arnemauer/IsaLib/ISA Ouderen/Ontvanger - Lamp/Glas met pictogrammen - achterkant.JPG

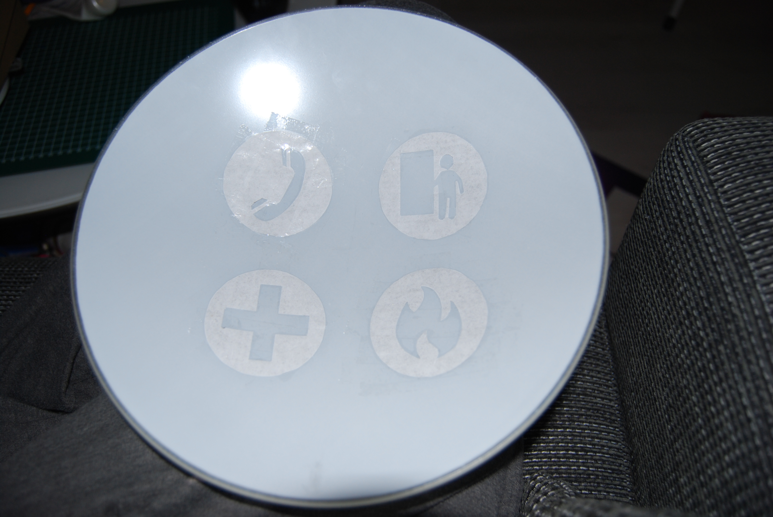
ISA Ouderen/Ontvanger - Lamp/Glas met pictogrammen - achterkant.JPG
