arnemauer/IsaLib/ISA Ouderen/Ontvanger - Lamp/Glas met pictogrammen - voorkant.JPG

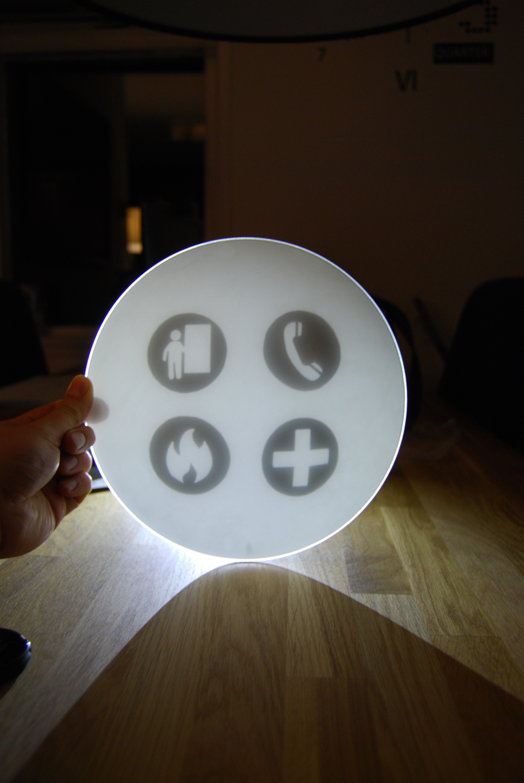
ISA Ouderen/Ontvanger - Lamp/Glas met pictogrammen - voorkant.JPG
