arnemauer/IsaLib/ISA Ouderen/Ontvanger - Lamp/Firmware (OUD)/LED PINS - KLEUREN.txt

Led: 0 - LINKSBOVEN - BLAUW
Led: 1 - LINKSBOVEN - GROEN
Led: 2 - LINKSBOVEN - ROOD

Led: 3 - WIT - ONDER
Led: 4 - WIT - LINKSBOVEN 
Led: 5 - WIT - MIDDENBOVEN 
Led: 6 - WIT - RECHTSBOVEN 

Led: 7 - RECHTSBOVEN - ROOD
Led: 8 - RECHTSBOVEN - GROEN
Led: 9 - RECHTSBOVEN - BLAUW

Led: 10 - RECHTSONDER - BLAUW
Led: 11 - RECHTSONDER - GROEN
Led: 12 - RECHTSONDER - ROOD

Led: 13 - LINKSONDER - BLAUW
Led: 14 - LINKSONDER - GROEN
Led: 15 - LINKSONDER - ROOD
