arnemauer/IsaLib/ISA Ouderen/Zender - Deurbel en Telefoon/Schematic/6n139 weerstand berekening.docx

Status | 6.8K | | 12.3K | | 39.4K
| 6.8K | 0K | 6.8K | 5.5K | 6.8K | 32.6K
Lijn in rust | 2.9mA | | 1.6mA | | 0.5mA
Rinkel 70v | 6.3mA | | 3.5mA | | 1.1mA
Rinkel 160v | 19.6mA | | 10.8mA | | 3.4mA
In gesprek | 0mA | | 0mA | | 0mA
