arnemauer/IsaLib/ISA Ouderen/Zender - Deurbel en Telefoon/Schematic/Deurbel meting/meting 1 benedenbel.XLS

Index | Value | Time | Unit
1 | 0,254 | 18:53:35:567 | DCV V
2 | 0,254 | 18:53:36:82 | DCV V
3 | 0,254 | 18:53:36:581 | DCV V
4 | 0,254 | 18:53:37:80 | DCV V
5 | 0,254 | 18:53:37:595 | DCV V
6 | 0,241 | 18:53:38:110 | DCV V
7 | 0,241 | 18:53:38:625 | DCV V
8 | 0,233 | 18:53:39:124 | DCV V
9 | -0,002 | 18:53:39:639 | DCV V
10 | -0,002 | 18:53:40:169 | DCV V
11 | 0,075 | 18:53:40:637 | DCV V
12 | 0,246 | 18:53:41:152 | DCV V
13 | 0,236 | 18:53:42:150 | DCV V
14 | 0,242 | 18:53:42:649 | DCV V
15 | 0,243 | 18:53:43:149 | DCV V
16 | 0,251 | 18:53:43:648 | DCV V
17 | 0,25 | 18:53:44:163 | DCV V
18 | 0,25 | 18:53:44:662 | DCV V
19 | 0,25 | 18:53:45:177 | DCV V
20 | 0,25 | 18:53:45:676 | DCV V
21 | 0,25 | 18:53:46:175 | DCV V
22 | 0,25 | 18:53:46:674 | DCV V
23 | 0,25 | 18:53:47:673 | DCV V
24 | 0,25 | 18:53:48:172 | DCV V
25 | 0,251 | 18:53:48:687 | DCV V
26 | 0,251 | 18:53:49:186 | DCV V
27 | 0,251 | 18:53:49:701 | DCV V
28 | 0,25 | 18:53:50:200 | DCV V
29 | 0,251 | 18:53:50:746 | DCV V
30 | 0,25 | 18:53:51:214 | DCV V
31 | 0,251 | 18:53:51:713 | DCV V
32 | 0,251 | 18:53:52:228 | DCV V
33 | 0,251 | 18:53:52:727 | DCV V
34 | 0,251 | 18:53:53:226 | DCV V
35 | 0,251 | 18:53:53:725 | DCV V
36 | 0,251 | 18:53:54:209 | DCV V
37 | 0,251 | 18:53:54:724 | DCV V
38 | 0,25 | 18:53:55:239 | DCV V
39 | 0,25 | 18:53:55:722 | DCV V
40 | 0,25 | 18:53:56:237 | DCV V
41 | 0,25 | 18:53:56:736 | DCV V
42 | 0,25 | 18:53:57:298 | DCV V
43 | 0,25 | 18:53:57:766 | DCV V
44 | 0,25 | 18:53:58:265 | DCV V
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
169 | 0,255 | 18:55:03:801 | DCV V
170 | 0,255 | 18:55:04:300 | DCV V
171 | 0,255 | 18:55:04:815 | DCV V
172 | 0,255 | 18:55:05:314 | DCV V
173 | 0,255 | 18:55:05:844 | DCV V
174 | 0,255 | 18:55:06:328 | DCV V
175 | 0,255 | 18:55:06:858 | DCV V
176 | 0,255 | 18:55:07:373 | DCV V
177 | 0,255 | 18:55:07:857 | DCV V
