arnemauer/IsaLib/ISA Gateway/Schematic - PCB/01-09-Board.png

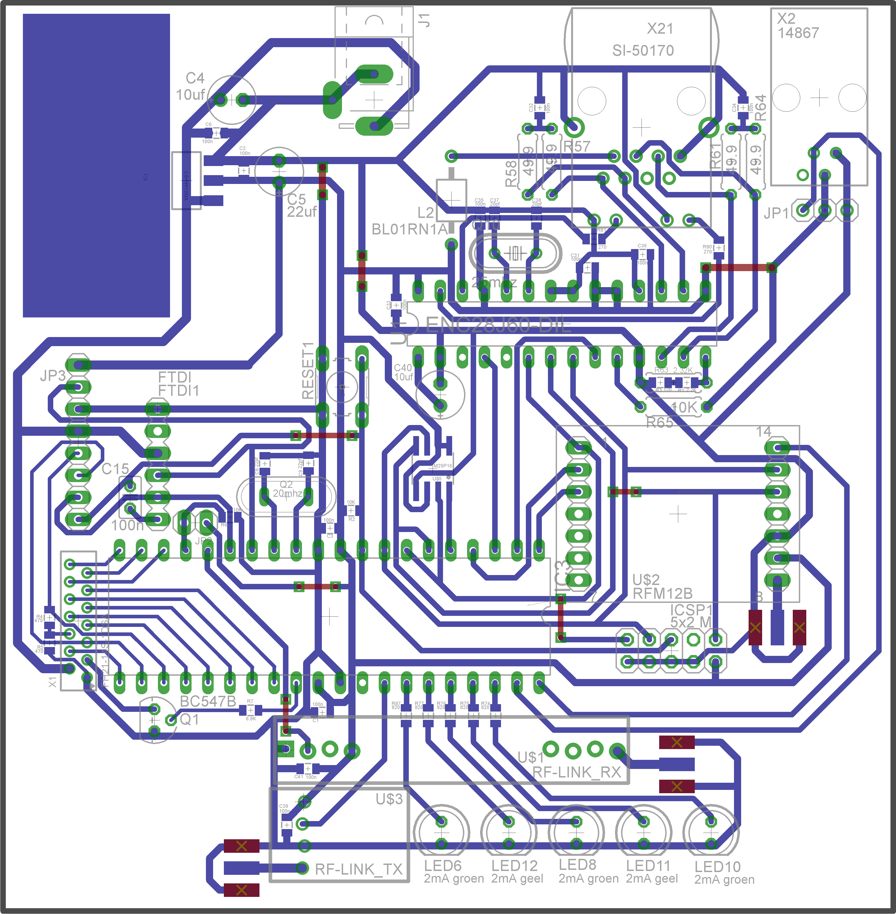
ISA Gateway/Schematic - PCB/01-09-Board.png
