arnemauer/IsaLib/ISA Gateway/Schematic - PCB/31-08-Board.png

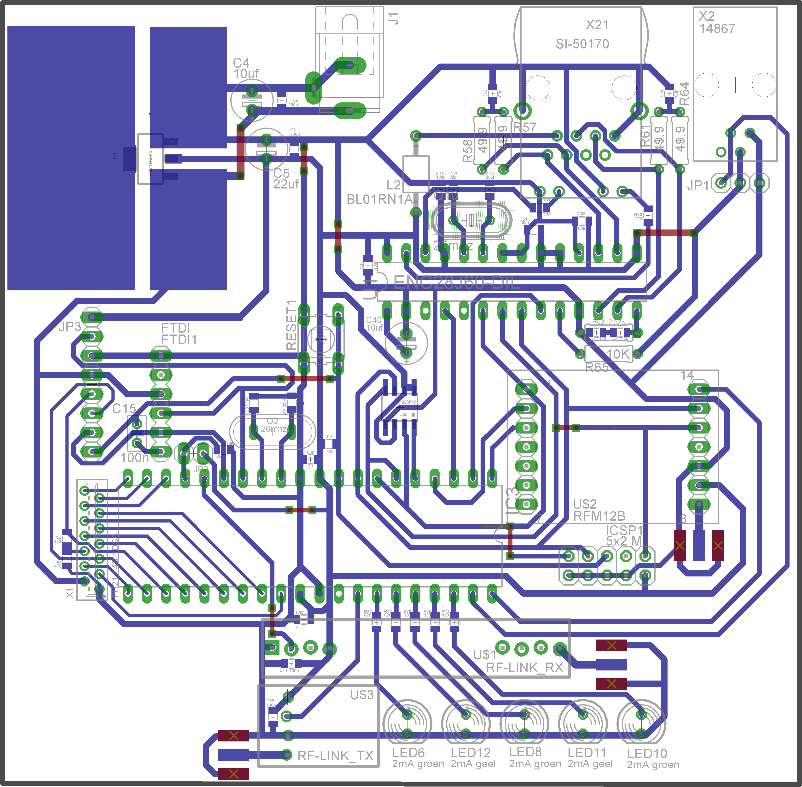
ISA Gateway/Schematic - PCB/31-08-Board.png
