arnemauer/IsaLib/ISA Ouderen/Ontvanger - Lamp/Glas met pictogrammen - voorkant 2.JPG

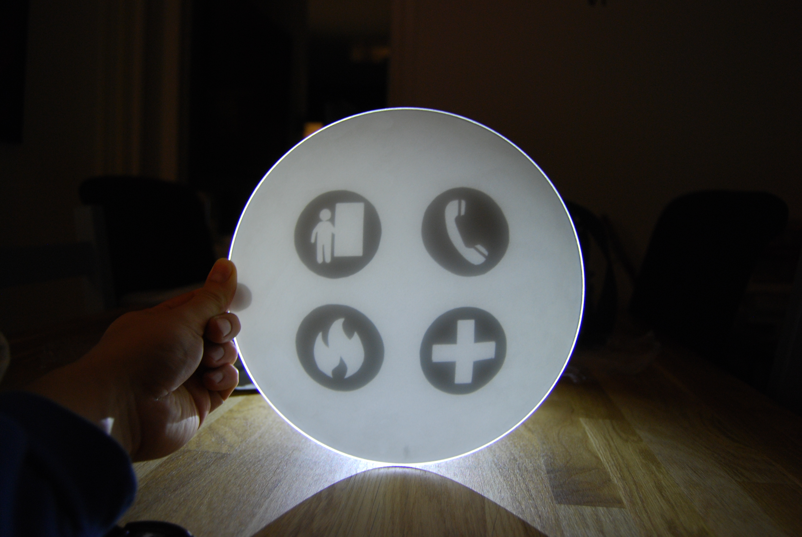
ISA Ouderen/Ontvanger - Lamp/Glas met pictogrammen - voorkant 2.JPG
