arnemauer/IsaLib/ISA Ouderen/Ontvanger - Lamp/Schematic/Schema.png

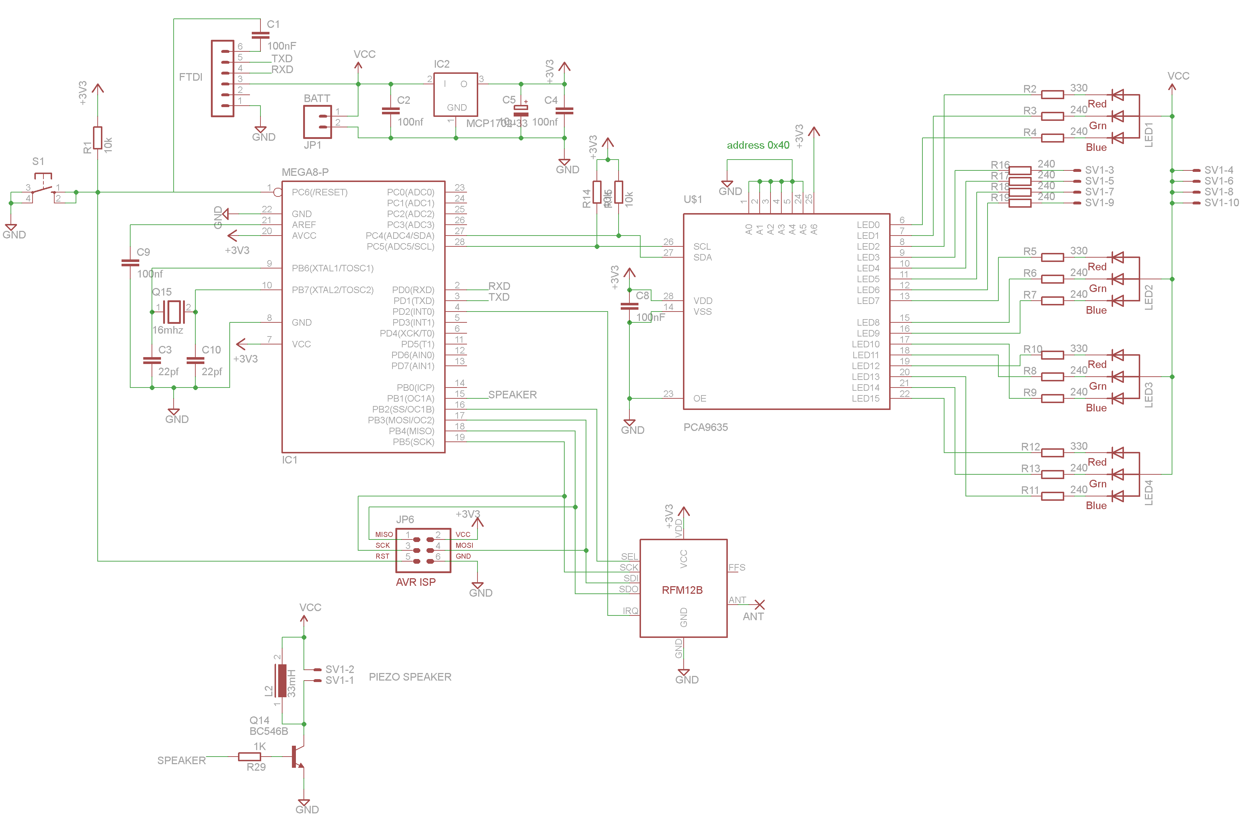
ISA Ouderen/Ontvanger - Lamp/Schematic/Schema.png
