arnemauer/IsaLib/ISA Ouderen/Zender - Deurbel en Telefoon/Schematic/Deurbel meting/meting 1 benedenbel.jpg

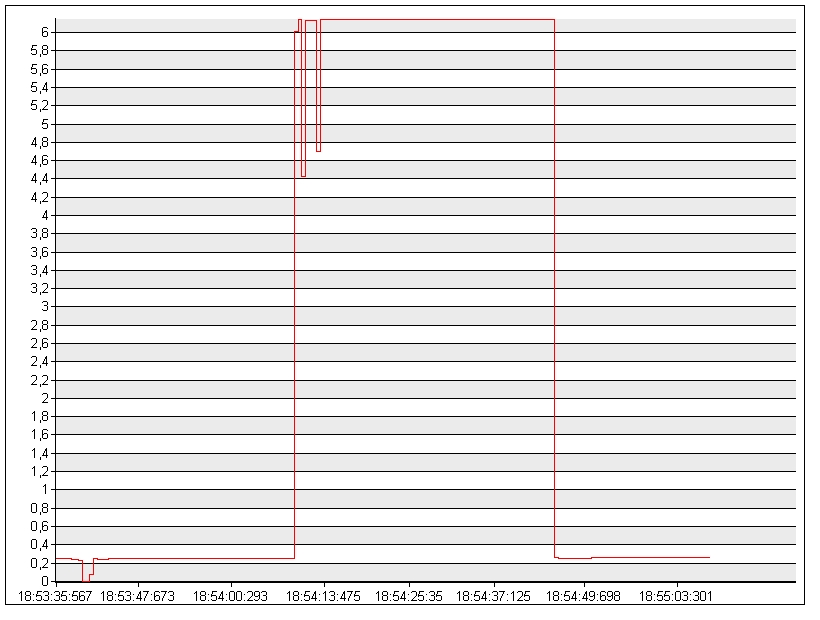
ISA Ouderen/Zender - Deurbel en Telefoon/Schematic/Deurbel meting/meting 1 benedenbel.jpg
