arnemauer/IsaLib/ISA Ouderen/Zender - Deurbel en Telefoon/Schematic/BOM/ISA Ouderen - Lamp Zender (versie 1).xlsx

Qty | Value | Device | Package | Shop | Price/s | Total |  | Parts | Description
2 | Antenna Wire | 1,6/0,8 | 1,6/0,8 |  |  |  | In huis | ANT, ANT2 | THROUGH-HOLE PAD
2 | 100k | R-EU_R0805 | R0805 | x | €0.06 | €0.12 | In huis | R2, R17 | RESISTOR, European symbol
6 | 100nf | C-EUC0805 | C0805 | x | €0.06 | €0.36 | In huis | C2, C3, C4, C8, C10, C11 | CAPACITOR, European symbol
4 | 10K | R-EU_R0805 | R0805 | x | €0.06 | €0.24 | In huis | R1, R8, R14, R16 | RESISTOR, European symbol
4 | 1N4007 | DIODE-DO214BA | DO214BA | Ebay | €0.02 | €0.08 | In huis | D7, D8, D9, D10 | DIODE
2 | 1N4148 | DIODESOD-323F | SOD-323F | Dickbest.nl | €0.06 | €0.12 | In huis | D1, D6 | Diode
2 | 1mm, 6x3,3x4,3mm | SWITCH-MOMENTARY-2-SMD-1101NE | TACTILE-SWITCH-1101NE | Dickbest.nl | €0.25 | €0.50 | In huis | S2, S3 | Various NO switches- pushbuttons, reed, etc
1 | 27V | ZENER-DIODEZD-2.5 | ZDIO-2.5 | Dickbest.nl | €0.10 | €0.10 | In huis | U$6 | Z-Diode
1 | 6.8K | R-EU_R0805 | R0805 | x | €0.06 | €0.06 | In huis | R6, R15 | RESISTOR, European symbol
1 | 680 | R-EU_R0805 | R0805 | x | €0.06 | €0.06 | In huis | R6, R15 | RESISTOR, European symbol
2 | 6N139 | HCPL0700 | SOIC08 | Ebay | €0.76 | €1.52 | In huis | OK2, OK4 | HEWLETT PACKARD OPTO COUPLER
2 | AVR-ISP-6VERT | AVR-ISP-6VERT | AVR-ISP-6 | x | €0.11 | €0.22 | In huis | JP3, JP6 | AVR ISP-6 Serial Programming Header
4 | BATTERY_1236_C | BATTERY_1236_C | BATTERY_1236_C | DX.com | €0.12 | €0.48 | Besteld | BATTERY_1, BATTERY_2, BATTERY_3, BATTERY_4 | SOC004
2 | BSH205 | MOSFET-PCHANNEL | SOT23 | Ebay | €1.44 | €2.88 | In huis | Q1, Q2
2 | FTDI | MA06-1 | MA06-1 | x | €0.07 | €0.14 | In huis | FTDI, FTDI2 | PIN HEADER
1 | MEGA8-AI | AVR-MEGA8-AI | TQFP32-08 | Ebay | €1.96 | €1.96 | In huis | IC4 | MICROCONTROLLER
1 | MEGA8-AI | MEGA8-AI | TQFP32-08@1 | Ebay | €1.96 | €1.96 | In huis | IC1 | MICROCONTROLLER
2 | RFM12B | RFM12B | RFM12B | ideetron.nl | €6.40 | €12.80 | Besteld | U$3, U$5
1 | 50K | TRIMPOT | TRIMPOT-5MM-V2 | Dickbest.nl | €0.85 | €0.85 | In huis | R3, R18 | Various small potentiometers for set-and-forget" applications"
1 | 10K | TRIMPOT | TRIMPOT-5MM-V2 | Dickbest.nl | €0.85 | €0.85 | In huis | R3, R18 | Various small potentiometers for set-and-forget" applications"
1 | s10k250 | VARISTOR-7,5 | R-7,5 | Dickbest.nl | €0.25 | €0.25 | In huis | R20 | VARISTOR
1 | PCB |  |  | Itead | €14.31 | €14.31 | Besteld
 |  |  |  |  | Totaal | €39.86
