arnemauer/IsaLib/ISA Ouderen/Zender - vor test ontvanger/Firmware - Deurbel/Fuses avrdude.rtf

Read Fuses:
avrdude -p atmega328 -c avrisp -P /dev/cu.usbserial-A600dWcL -b 9600 -U lfuse:r:-:h -U hfuse:r:-:h -U efuse:r:-:h -U lock:r:-:h

Compile optiboot
Add in make file:

atmega328_pro8: TARGET = atmega328_pro_8MHz
atmega328_pro8: CHIP = atmega328
atmega328_pro8:
$(MAKE) $(CHIP) AVR_FREQ=8000000L LED_START_FLASHES=3 DBAUD_RATE=9600
mv $(PROGRAM)_$(CHIP).hex $(PROGRAM)_$(TARGET).hex
mv $(PROGRAM)_$(CHIP).lst $(PROGRAM)_$(TARGET).lst

atmega328_pro8_isp: atmega328_pro8
atmega328_pro8_isp: TARGET = atmega328_pro_8MHz
atmega328_pro8_isp: MCU_TARGET = atmega328p
# 512 byte boot, SPIEN

atmega328_pro8_isp: HFUSE ?= DC
# Low power xtal (16MHz) 16KCK/14CK+65ms

atmega328_pro8_isp: LFUSE ?= E2
# 2.7V brownout

atmega328_pro8_isp: EFUSE ?= 06
atmega328_pro8_isp: isp

COMPILE COMMAND:
make atmega328_pro8 BAUD_RATE=9600

Write optiboot
LOW C2
HIGH DC
EXTENDED FE of 06

avrdude -p m328p -b 9600 -c avrisp -P /dev/tty.usbserial-A600dWcL -U flash:w:optiboot_atmega328_384_8.hex -U efuse:w:0x06:m -U hfuse:w:0xDC:m -U lfuse:w:0xE2:m -U lock:w:0x0F:m

avrdude -p m328p -b 9600 -c avrisp -P /dev/tty.usbserial-A600dWcL -U flash:w:ISA_OUDEREN_ZENDER.hex -U efuse:w:0x06:m -U hfuse:w:0xDC:m -U lfuse:w:0xE2:m -U lock:w:0x0F:m

avrdude -p m328p -b 115200 -c arduino -P /dev/tty.usbserial-A8009NB0 -U flash:w:ISA_OUDEREN_ZENDER.hex

avrdude -p m328p -b 9600 -c avrisp -P /dev/tty.usbserial-A600dWcL -U flash:w:ISA_OUDEREN_ZENDER.hex -U efuse:w:0x05:m -U hfuse:w:0xDA:m -U lfuse:w:0xE2:m -U lock:w:0x0F:m

avrdude -p m328p -b 9600 -c avrisp -P /dev/tty.usbserial-A600dWcL -U efuse:w:0x06:m -U hfuse:w:0xDC:m -U lfuse:w:0xC2:m -U lock:w:0x0F:m

ISA_OUDEREN_ZENDER

-CC:\WinAVR-20100110\bin\avrdude.conf -v -v -pm328p -carduino -P\\.\COM7 -b57600 -D -Uflash:w:"$(ProjectDir)Debug\$(ItemFileName).hex":i
