arnemauer/IsaLib/ISA Ouderen/Ontvanger - Lamp/Schematic/ISA Ouderen - Lamp Ontvanger.pdf

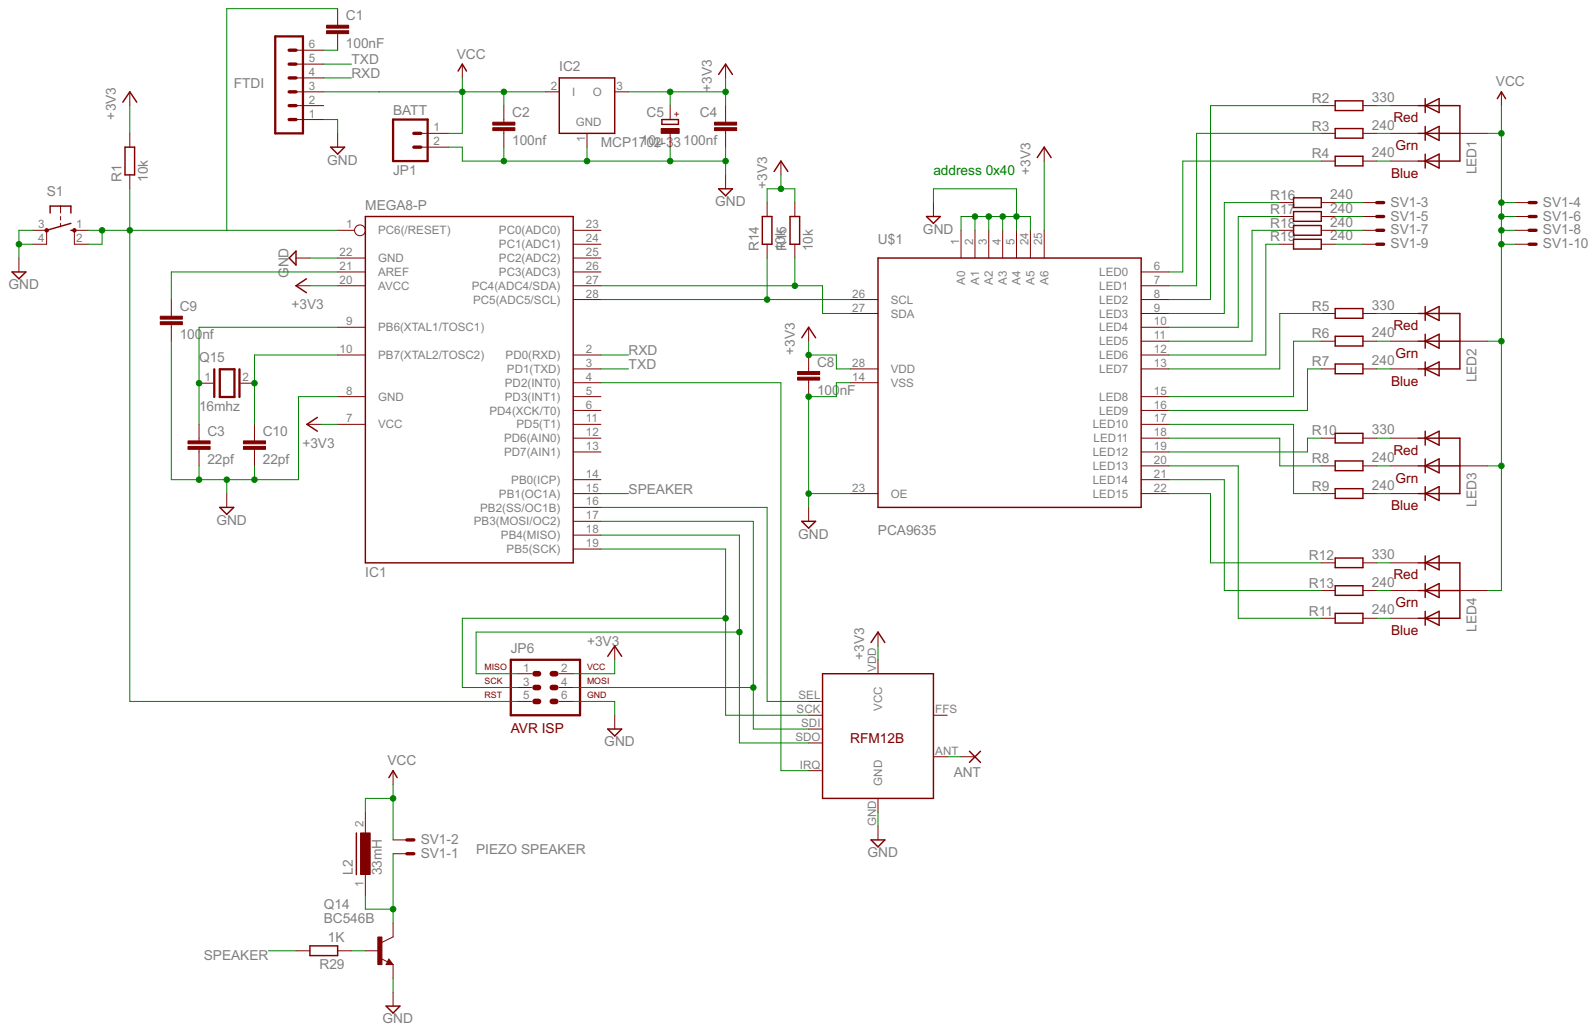
[picture p8: page 1]

10kGND MCP1702-33 100nF 100nf 10µ GND 100nf GND BATT GND BC546B GND 1K VCC 16mhz +3V3 GND +3V3 +3V3 VCC VCC PCA9635GND 100nF +3V3GND +3V3 +3V3100nf +3V3 GND MEGA8-P +3V3 22pf 22pf 330 240 240 330 240 240 240 240 330 240 330 240 33mH 10k 10k +3V3 GND 240 240 240 240 PIEZO SPEAKER 123456 FTDI R1 GND IC2I 2 O 3 1 C1 C2 C5 C4 JP1 12 ANT Q14 R29 Q15 1 2 LED0 6 LED1 7 LED2 8 LED3 9 LED4 10 LED5 11 LED6 12 LED7 13 LED8 15 LED9 16 LED10 17 LED11 18 LED12 19 LED13 20 LED14 21 LED15 22 SCL 26 SDA 27 VDD 28 VSS 14 OE 23 A0 1 A1 2 A2 3 A3 4 A4 5 A5 24 A6 25U$1 C8 JP63 2 51 64 SEL SCK SDI SDO ANT VCC VDD GND GND IRQ FFS C9 IC1 PB5(SCK) 19 PB7(XTAL2/TOSC2) 10 PB6(XTAL1/TOSC1) 9 GND 8 VCC 7 GND 22 AREF 21 AVCC 20 PB4(MISO) 18 PB3(MOSI/OC2) 17 PB2(SS/OC1B) 16 PB1(OC1A) 15 PB0(ICP) 14 PD7(AIN1) 13 PD6(AIN0) 12 PD5(T1) 11 PD4(XCK/T0) 6 PD3(INT1) 5 PD2(INT0) 4 PD1(TXD) 3 PD0(RXD) 2 PC5(ADC5/SCL) 28 PC4(ADC4/SDA) 27 PC3(ADC3) 26 PC2(ADC2) 25 PC1(ADC1) 24 PC0(ADC0) 23 PC6(/RESET) 1 C3 C10 R2R3R4R5R6R7R8R9R10 R11 R12 R13 L2 2 1 R14 R15 SV1-1 SV1-2 SV1-3 SV1-4 SV1-5 SV1-6 SV1-7 SV1-8 SV1-9 SV1-10 S1 3 1 4 2 LED1 LED2 LED3 LED4 R16 R17 R18 R19 RXD RXD TXD TXD SPEAKER SPEAKER+ AVR ISP SCK MOSI MISO VCC RST GND RFM12B Red Grn Blue Red Grn Blue Red Grn Blue Red Grn Blue address 0x40
