arnemauer/IsaLib/ISA Gateway/Schematic - PCB/01-09-Central relay.pdf

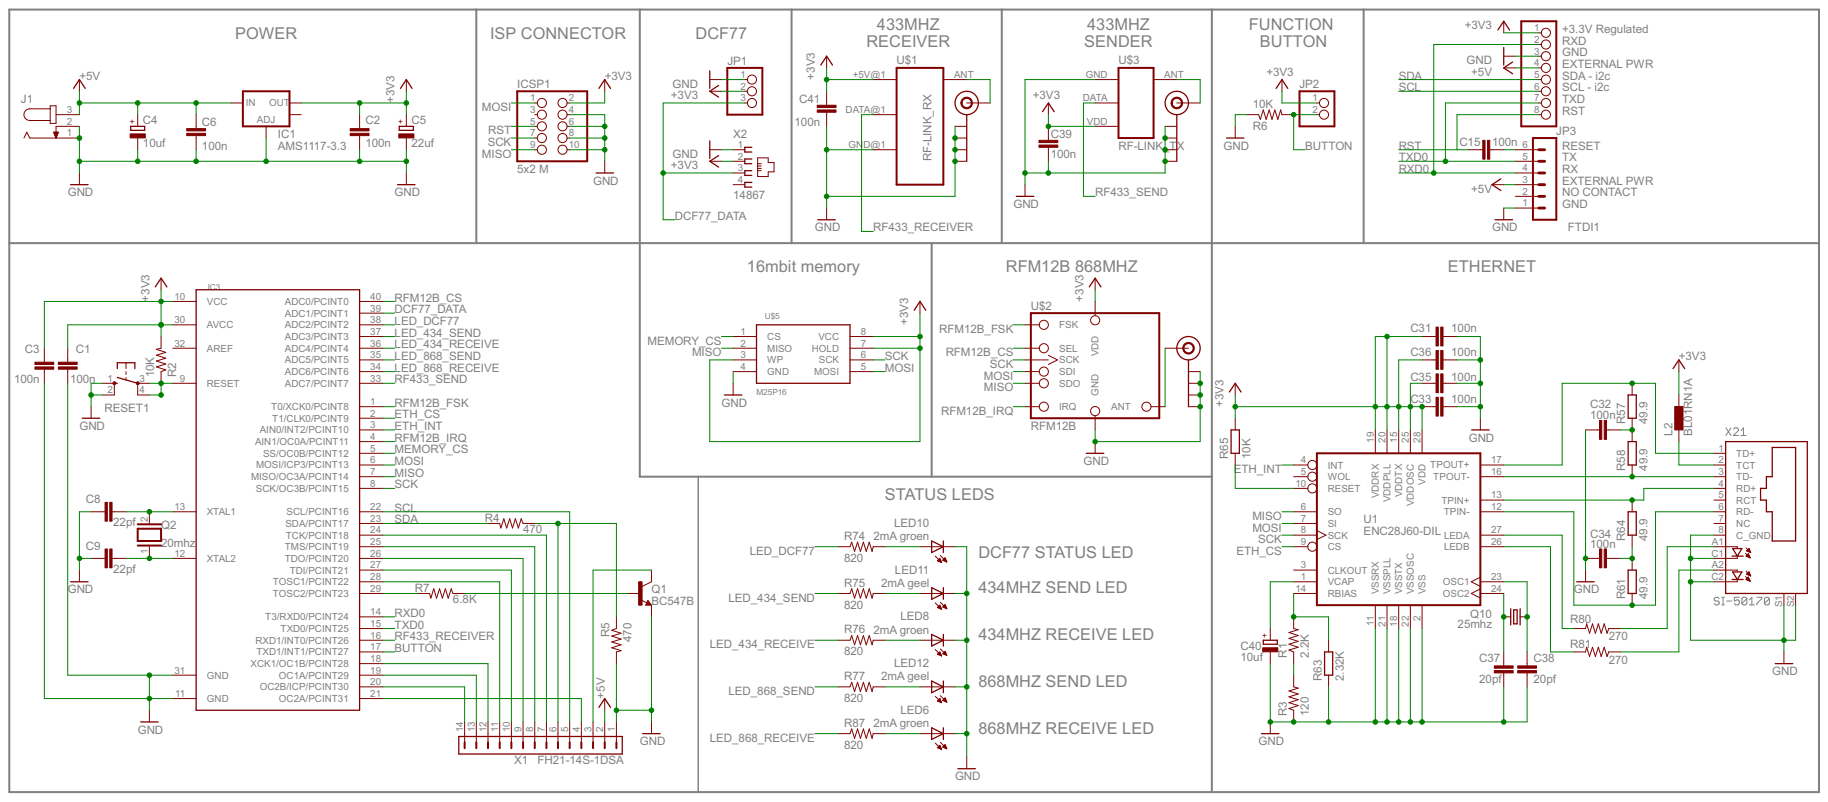
[picture p9: page 1]

7 8
9 10
