arnemauer/IsaLib/ISA Gateway/Schematic - PCB/31-08-Central relay.pdf

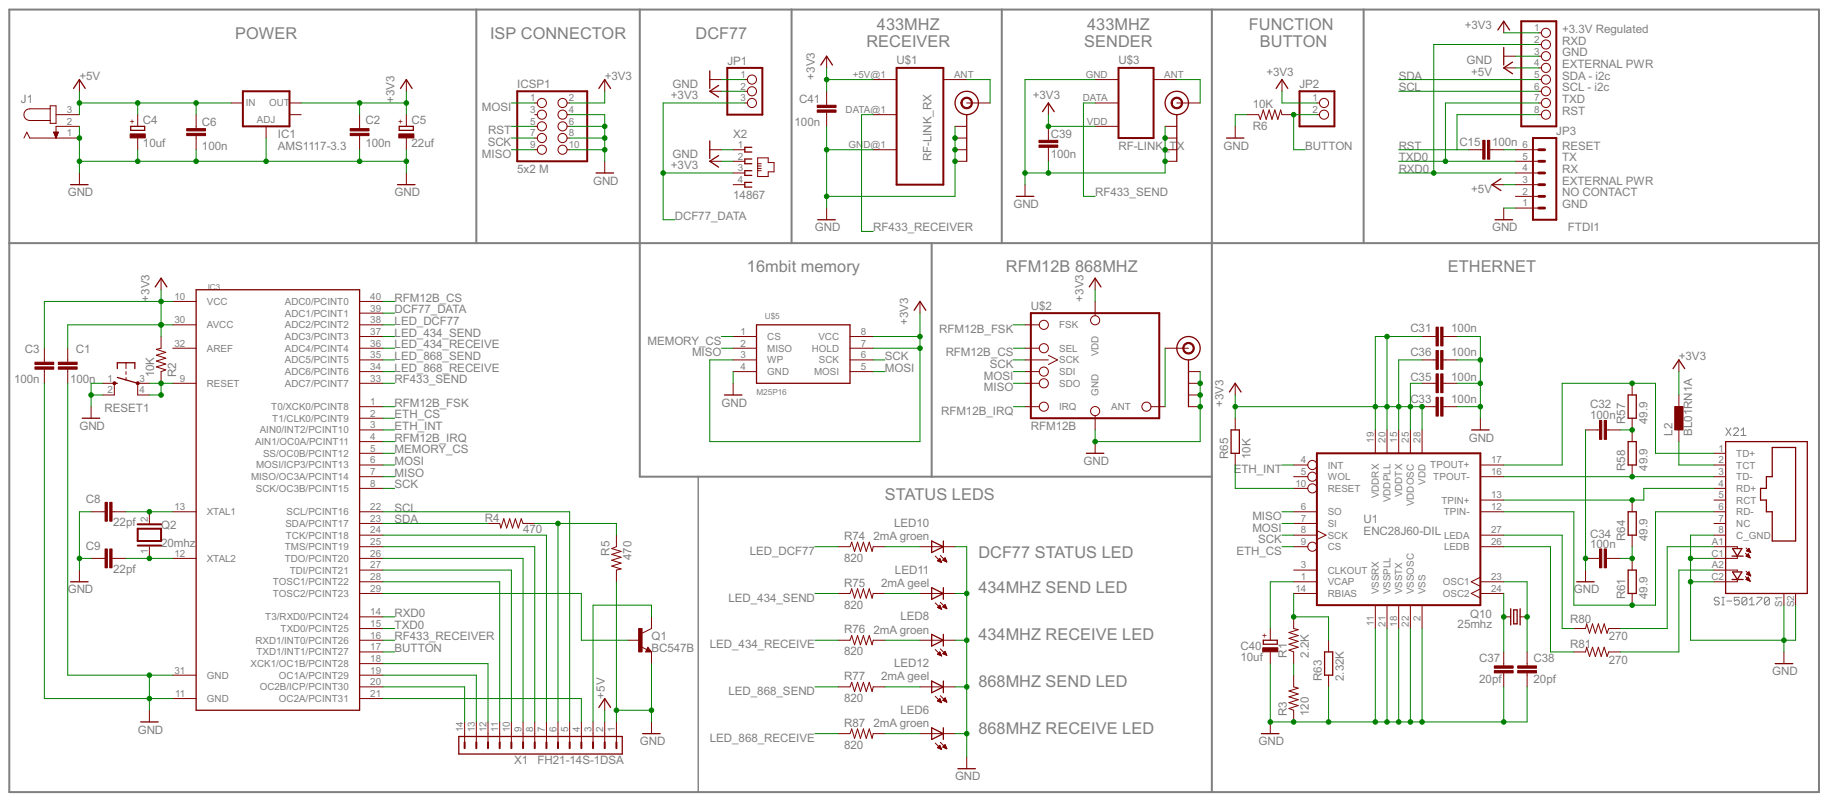
[picture p10: page 1]

7 8
9 10
