arnemauer/IsaLib/ISA Gateway/Schematic - PCB/Central relay.pdf

7 8
9 10
