arnemauer/IsaLib/ISA Gateway/Schematic - PCB/Central relay2.pdf

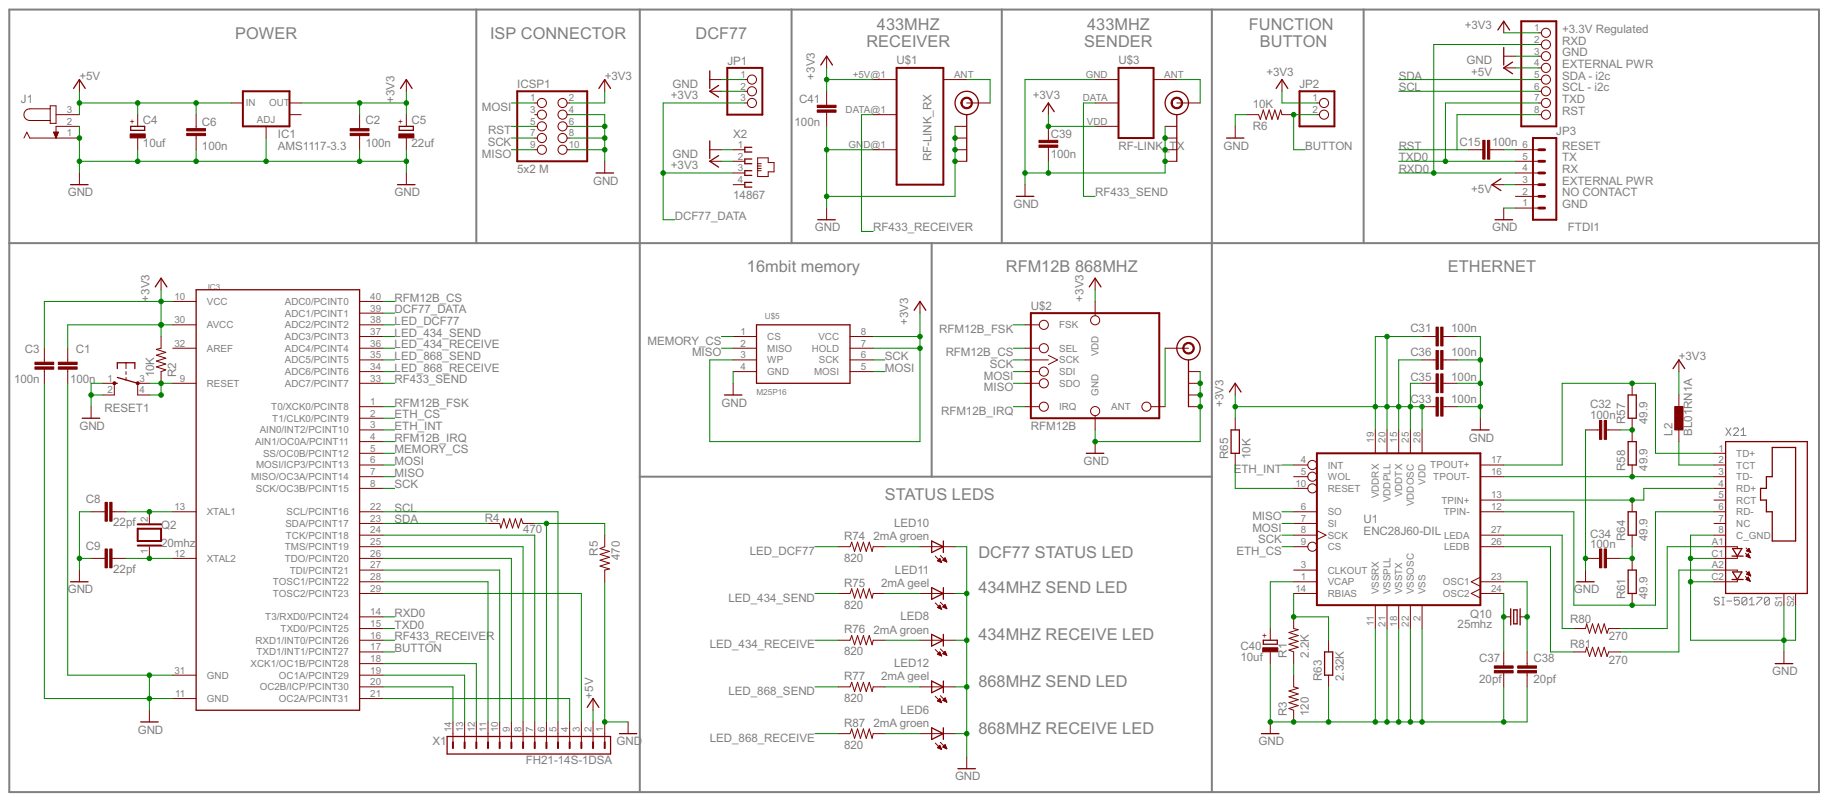
[picture p11: page 1]

7 8
9 10
