arnemauer/IsaLib/ISA Ouderen/Zender - Deurbel en Telefoon/Schematic/ISA Ouderen - Lamp Zender.pdf

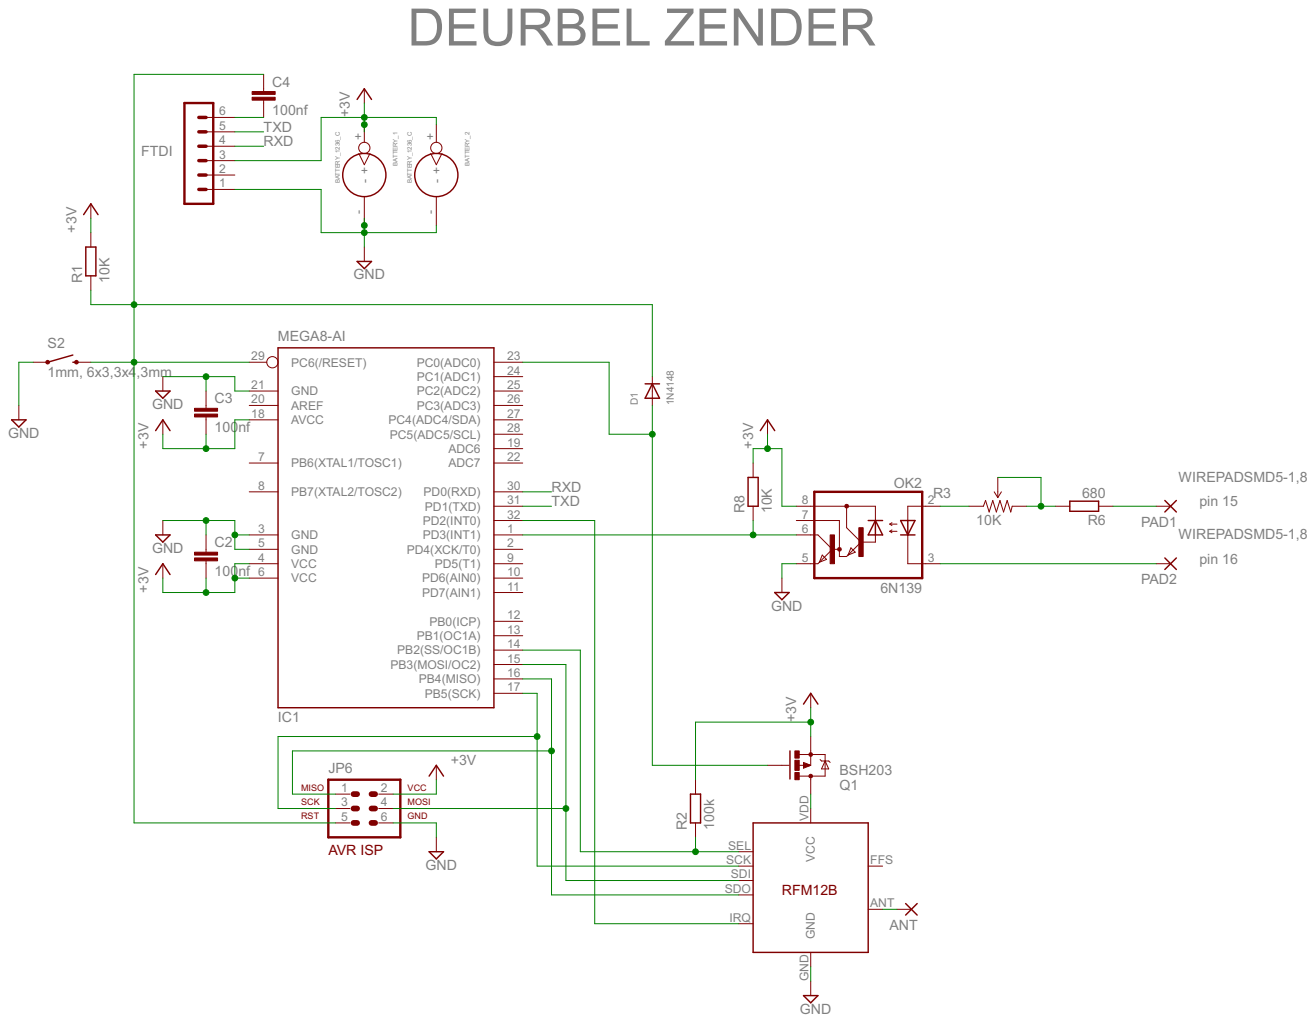
[picture p12: page 1]

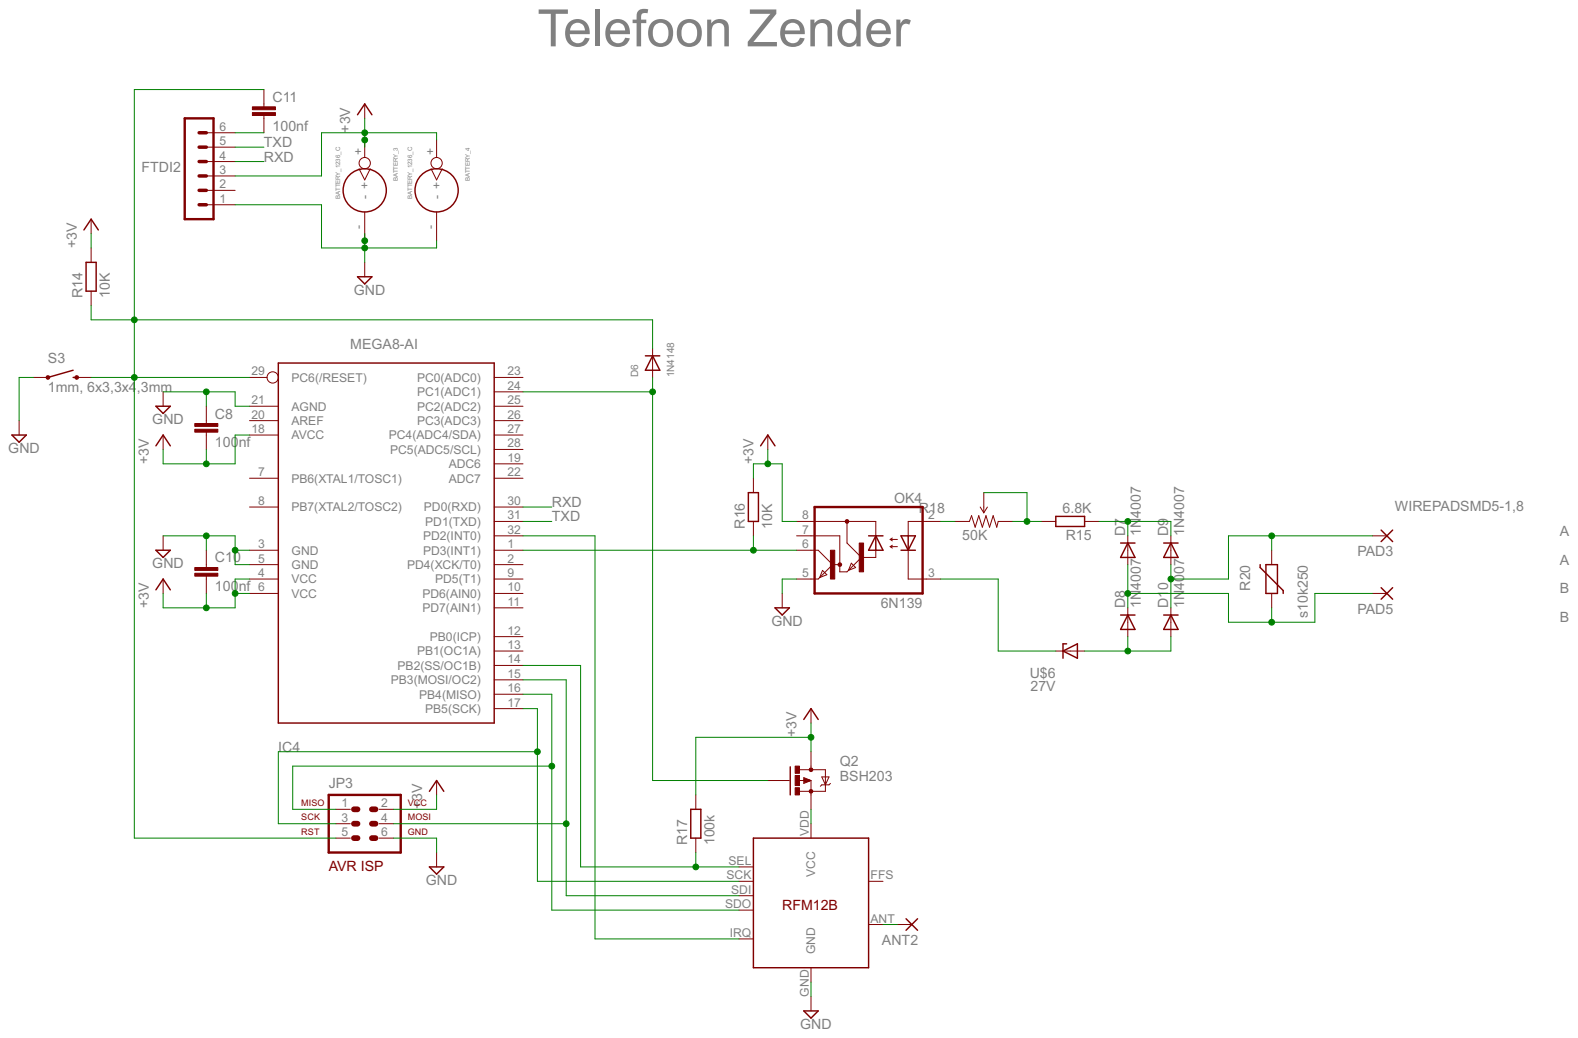
[picture p13: page 2]
