arnemauer/IsaLib/ISA Ouderen/Ontvanger - Lamp/Firmware (OUD)/ISA ouderen deurbel ontvanger - applicatie proces.pdf

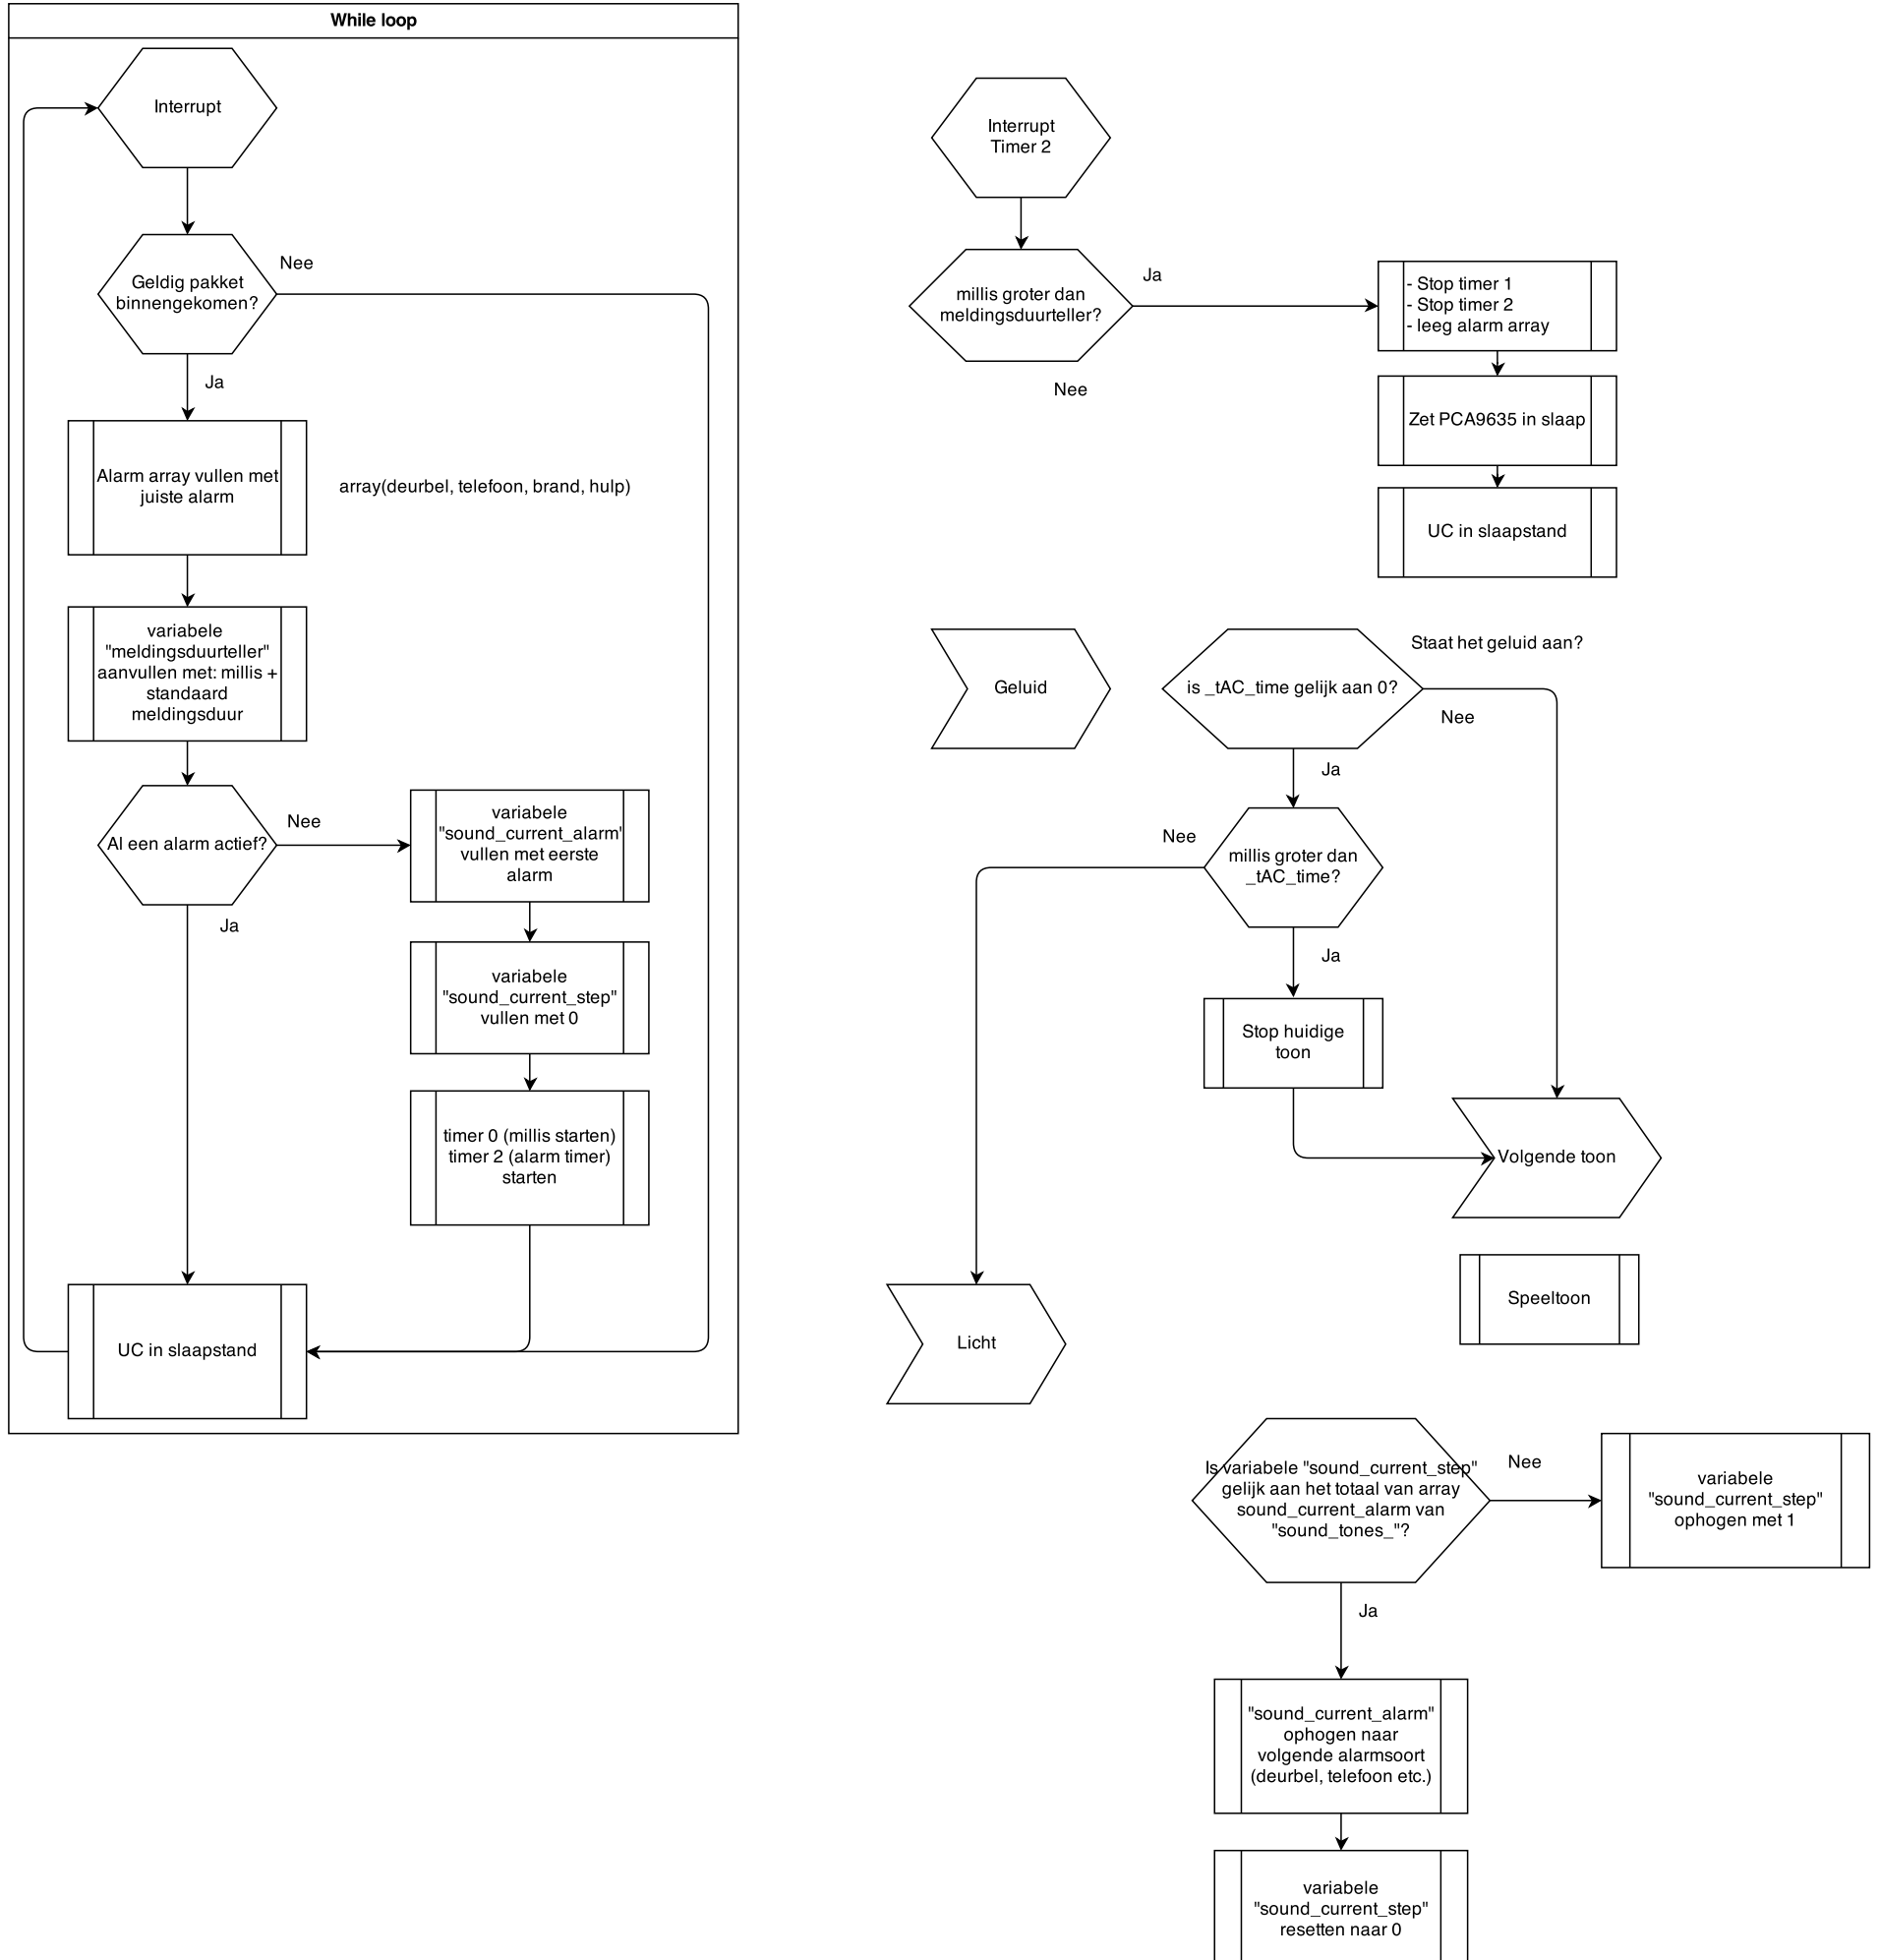
[picture p14: page 1]
