arnemauer/IsaLib/ISA Ouderen/Zender - Deurbel en Telefoon/Schematic/ISA Ouderen - Lamp Zender.brd

## EAGLE design ISA Ouderen/Zender - Deurbel en Telefoon/Schematic/ISA Ouderen - Lamp Zender.brd (2014-07-26)

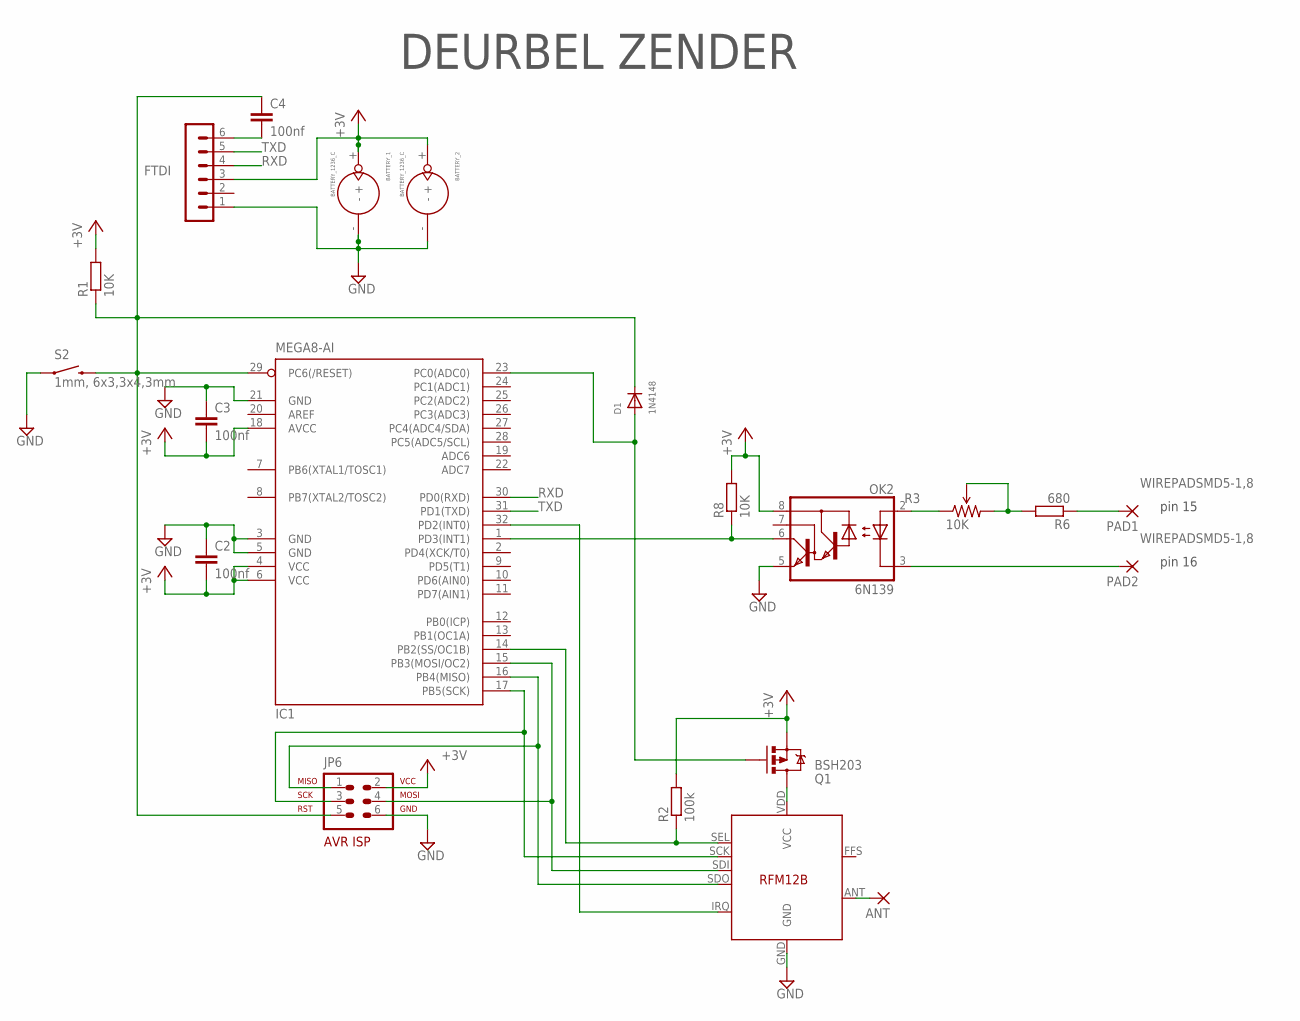
[picture p15: schematic ISA Ouderen - Lamp Zender.sch, sheet 1]

Parts:
ANT: 1,6/0,8
BATTERY_1, BATTERY_2: BATTERY_1236_C
C2, C3, C4: 100nf; C0805
D1: 1N4148; SOD-323F
FTDI: FTDI; MA06-1
IC1: MEGA8-AI; TQFP32-08@1
JP6: AVR-ISP-6VERT; AVR-ISP-6
OK2: 6N139; SOIC08
PAD1, PAD2: WIREPADSMD5-1,8; 5-1,8
Q1: BSH203; SOT23
R1, R8: 10K; R0805
R2: 100k; R0805
R3: 10K; TRIMPOT-5MM-V2
R6: 680; R0805
S2: 1mm, 6x3,3x4,3mm; TACTILE-SWITCH-1101NE
U$3: RFM12B

Connections:
+3V3: BATTERY_1.+, BATTERY_2.+, C2.2, C3.2, FTDI.3, IC1.4 (VCC), IC1.6 (VCC), IC1.18 (AVCC), JP6.2, OK2.8 (VCC), Q1.2 (S), R1.2, R2.2, R8.2; also elsewhere on the board
GND: BATTERY_1.-, BATTERY_2.-, C2.1, C3.1, FTDI.1, IC1.3 (GND), IC1.5 (GND), IC1.21 (GND), JP6.6, OK2.5 (GND), S2.P$1 (1), U$3.GND; also elsewhere on the board
unnamed: Q1.3 (D), U$3.VDD (VCC)
unnamed: D1.A, IC1.23 (PC0(ADC0)), Q1.1 (G)
unnamed: ANT.1, U$3.ANT
unnamed: IC1.14 (PB2(SS/OC1B)), R2.1, U$3.SEL
unnamed: IC1.32 (PD2(INT0)), U$3.IRQ
unnamed: PAD1.1, R6.1
unnamed: IC1.16 (PB4(MISO)), JP6.1, U$3.SDO
unnamed: OK2.2 (A), R3.A (CCW)
unnamed: IC1.17 (PB5(SCK)), JP6.3, U$3.SCK
unnamed: C4.2, FTDI.6
unnamed: OK2.3 (C), PAD2.1
unnamed: IC1.1 (PD3(INT1)), OK2.6 (VO), R8.1
unnamed: R3.B (WIPER), R3.C (CW), R6.2
unnamed: IC1.15 (PB3(MOSI/OC2)), JP6.4, U$3.SDI
RST: C4.1, D1.C, IC1.29 (PC6(/RESET)), JP6.5, R1.1, S2.P$2 (2)
RXD: FTDI.4, IC1.30 (PD0(RXD)); also elsewhere on the board
TXD: FTDI.5, IC1.31 (PD1(TXD)); also elsewhere on the board

Notes on the sheet:
pin 15
pin 16
DEURBEL ZENDER

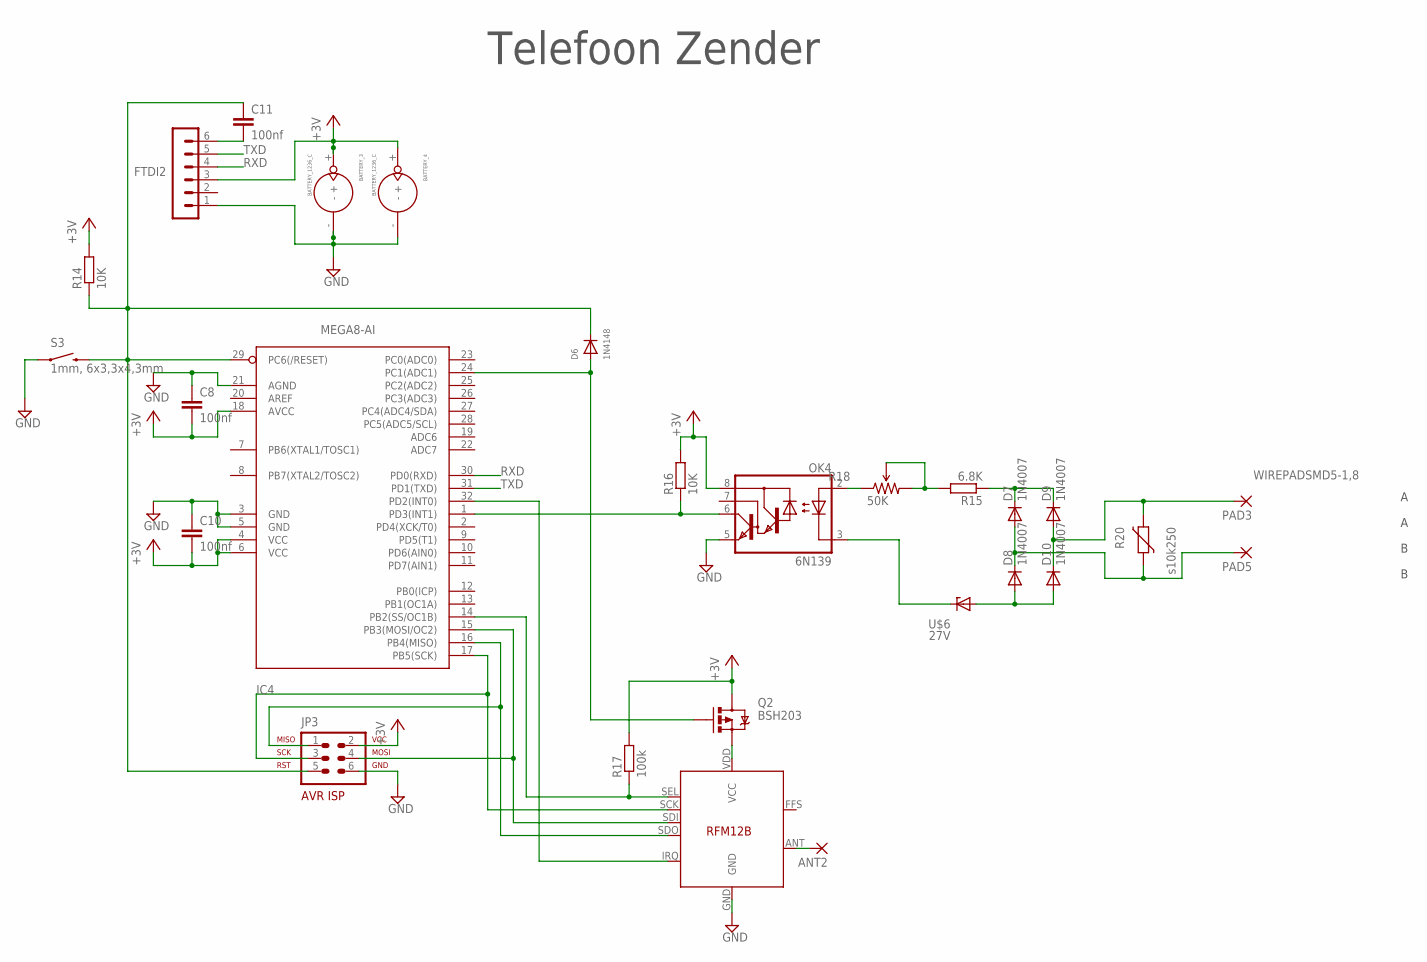
[picture p16: schematic ISA Ouderen - Lamp Zender.sch, sheet 2]

Parts:
ANT2: 1,6/0,8
BATTERY_3, BATTERY_4: BATTERY_1236_C
C8, C10, C11: 100nf; C0805
D6: 1N4148; SOD-323F
D7, D8, D9, D10: 1N4007; DO214BA
FTDI2: FTDI; MA06-1
IC4: MEGA8-AI; TQFP32-08
JP3: AVR-ISP-6VERT; AVR-ISP-6
OK4: 6N139; SOIC08
PAD3, PAD5: WIREPADSMD5-1,8; 5-1,8
Q2: BSH203; SOT23
R14, R16: 10K; R0805
R15: 6.8K; R0805
R17: 100k; R0805
R18: 50K; TRIMPOT-5MM-V2
R20: s10k250; R-7,5
S3: 1mm, 6x3,3x4,3mm; TACTILE-SWITCH-1101NE
U$5: RFM12B
U$6: 27V; ZDIO-2.5

Connections:
+3V3: BATTERY_3.+, BATTERY_4.+, C8.2, C10.2, FTDI2.3, IC4.4 (VCC), IC4.6 (VCC), IC4.18 (AVCC), JP3.2, OK4.8 (VCC), Q2.3 (D), R14.2, R16.2, R17.2; also elsewhere on the board
GND: BATTERY_3.-, BATTERY_4.-, C8.1, C10.1, FTDI2.1, IC4.3 (GND), IC4.5 (GND), IC4.21 (AGND), JP3.6, OK4.5 (GND), S3.P$1 (1), U$5.GND; also elsewhere on the board
unnamed: IC4.14 (PB2(SS/OC1B)), R17.1, U$5.SEL
unnamed: IC4.32 (PD2(INT0)), U$5.IRQ
unnamed: C11.2, FTDI2.6
unnamed: IC4.15 (PB3(MOSI/OC2)), JP3.4, U$5.SDI
unnamed: ANT2.1, U$5.ANT
unnamed: IC4.16 (PB4(MISO)), JP3.1, U$5.SDO
unnamed: IC4.17 (PB5(SCK)), JP3.3, U$5.SCK
unnamed: OK4.2 (A), R18.A (CCW)
unnamed: OK4.3 (C), U$6.C
unnamed: IC4.1 (PD3(INT1)), OK4.6 (VO), R16.1
unnamed: R15.2, R18.B (WIPER), R18.C (CW)
unnamed: Q2.2 (S), U$5.VDD (VCC)
unnamed: D6.A, IC4.24 (PC1(ADC1)), Q2.1 (G)
unnamed: D9.A, D10.C, PAD3.1, R20.2
unnamed: D7.A, D8.C, PAD5.1, R20.1
unnamed: D8.A, D10.A, U$6.A
unnamed: D7.C, D9.C, R15.1
RST2: C11.1, D6.C, IC4.29 (PC6(/RESET)), JP3.5, R14.1, S3.P$2 (2)
RXD: FTDI2.4, IC4.30 (PD0(RXD)); also elsewhere on the board
TXD: FTDI2.5, IC4.31 (PD1(TXD)); also elsewhere on the board

Notes on the sheet:
Telefoon Zender

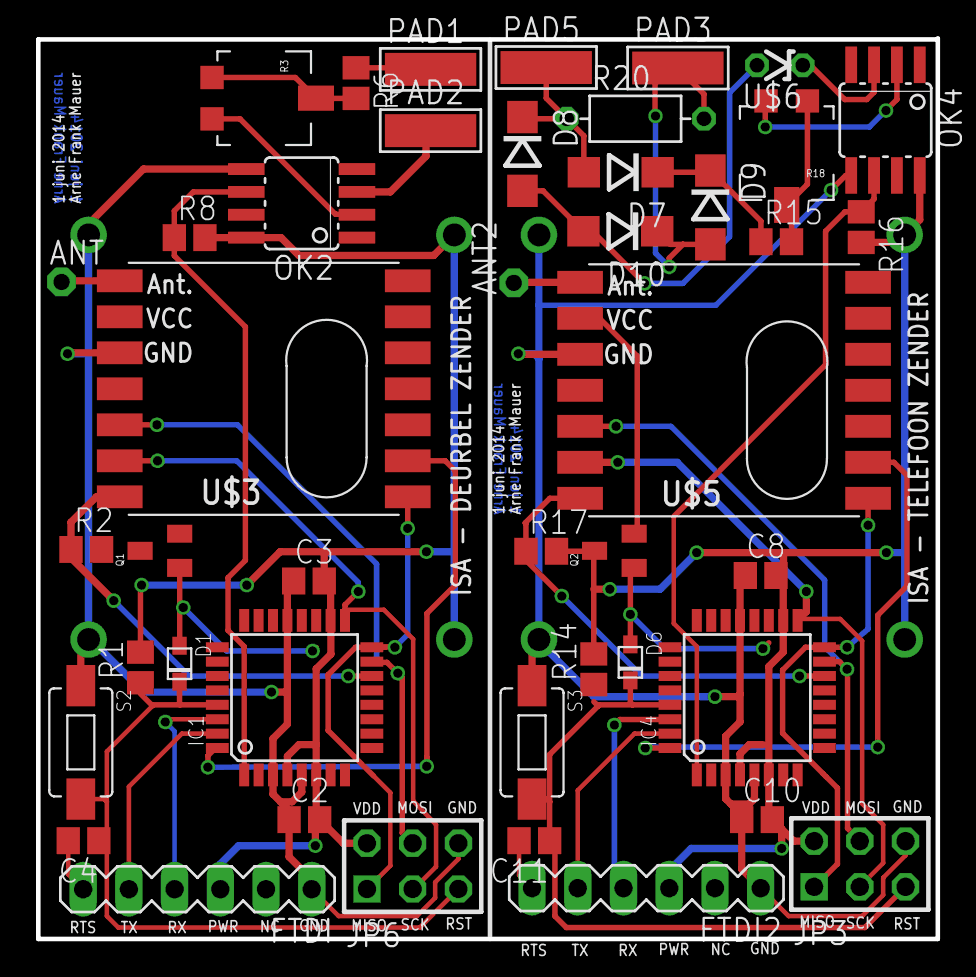
[picture p17: board ISA Ouderen - Lamp Zender.brd from above]

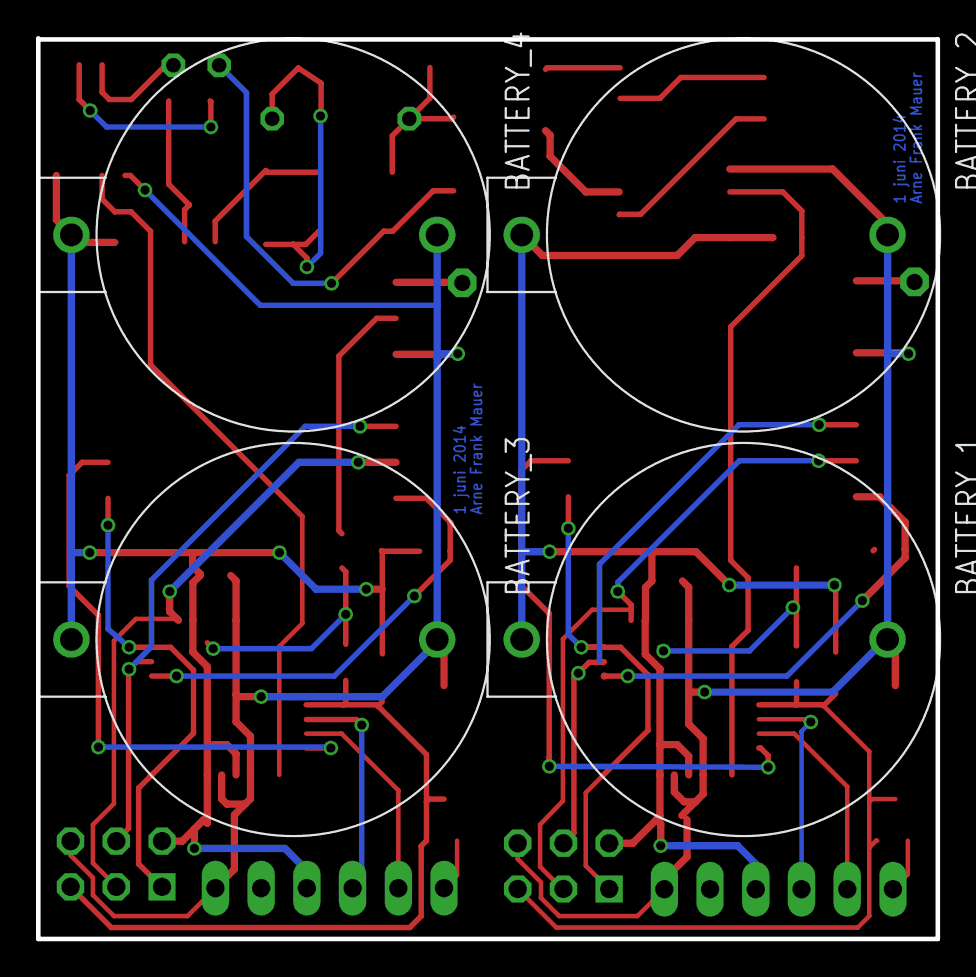
[picture p18: board ISA Ouderen - Lamp Zender.brd from below]

Board: 2 copper layers, 50.0 x 50.0 mm, 48 parts (4 on the bottom side), 37 nets.
