arnemauer/IsaLib/ISA Ouderen/Ontvanger - Lamp/Schematic/ISA Ouderen - Lamp Ontvanger.brd

## EAGLE design ISA Ouderen/Ontvanger - Lamp/Schematic/ISA Ouderen - Lamp Ontvanger.brd (2013-12-22)

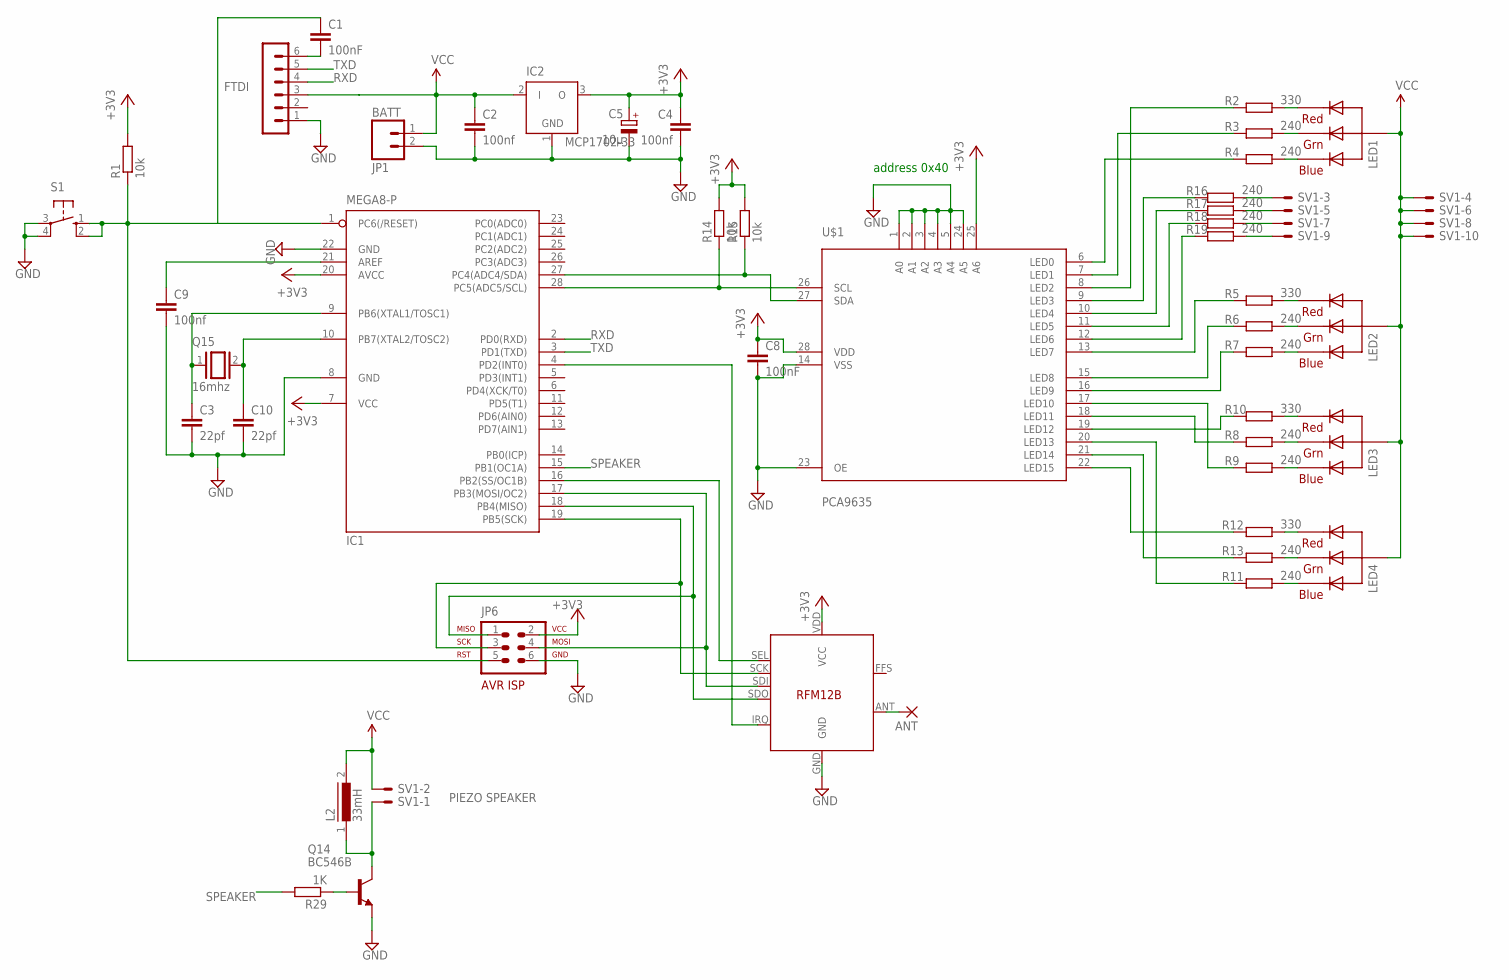
[picture p19: schematic ISA Ouderen - Lamp Ontvanger.sch]

Parts:
ANT: 1,6/0,8
C1, C8: 100nF; C025-024X044
C2, C4, C9: 100nf; C025-024X044
C3, C10: 22pf; C025-024X044
C5: 10µ; E1,8-4
FTDI: FTDI; MA06-1
IC1: MEGA8-P; DIL28-3
IC2: MCP1702-33; TO92
JP1: BATT; 1X02_LOCK_LONGPADS
JP6: AVR-ISP-6VERT; AVR-ISP-6
L2: 33mH; 82114R
LED1, LED2, LED3, LED4: RGBLED_CA-5MM; LED5MMRGB
Q14: BC546B; TO92-EBC
Q15: 16mhz; QS
R1, R14, R15: 10k; 0207/7
R2, R5, R10, R12: 330; 0207/7
R3, R4, R6, R7, R8, R9, R11, R13: 240; 0207/7
R16, R17, R18, R19: 240; 0207/2V
R29: 1K; 0207/7
S1: 10-XX; B3F-10XX
SV1: ML10LE; ML10L
U$1: PCA9635
U$3: RFM12B

Connections:
+3V3: C4.1, C5.+, C8.1, IC1.7 (VCC), IC1.20 (AVCC), IC2.3 (O), JP6.2, R1.2, R14.2, R15.2, U$1.25 (A6), U$1.28 (VDD), U$3.VDD (VCC)
GND: C2.2, C3.2, C4.2, C5.-, C8.2, C9.2, C10.2, FTDI.1, IC1.8 (GND), IC1.22 (GND), IC2.1 (GND), JP1.2, JP6.6, Q14.E, S1.3, S1.4 (P1), U$1.1 (A0), U$1.2 (A1), U$1.3 (A2), U$1.4 (A3), U$1.5 (A4), U$1.14 (VSS), U$1.23 (OE), U$1.24 (A5), U$3.GND
unnamed: C3.1, IC1.9 (PB6(XTAL1/TOSC1)), Q15.1
unnamed: IC1.28 (PC5(ADC5/SCL)), R14.1, U$1.26 (SCL)
unnamed: ANT.1, U$3.ANT
unnamed: IC1.16 (PB2(SS/OC1B)), U$3.SEL
unnamed: LED1.1 (RED), R2.2
unnamed: LED1.3 (GREEN), R3.2
unnamed: IC1.4 (PD2(INT0)), U$3.IRQ
unnamed: LED1.4 (BLUE), R4.2
unnamed: LED2.1 (RED), R5.2
unnamed: IC1.27 (PC4(ADC4/SDA)), R15.1, U$1.27 (SDA)
unnamed: LED2.3 (GREEN), R6.2
unnamed: LED2.4 (BLUE), R7.2
unnamed: IC1.18 (PB4(MISO)), JP6.1, U$3.SDO
unnamed: LED3.1 (RED), R10.2
unnamed: LED3.3 (GREEN), R8.2
unnamed: LED3.4 (BLUE), R9.2
unnamed: LED4.1 (RED), R12.2
unnamed: LED4.3 (GREEN), R13.2
unnamed: IC1.19 (PB5(SCK)), JP6.3, U$3.SCK
unnamed: C1.2, FTDI.6
unnamed: C10.1, IC1.10 (PB7(XTAL2/TOSC2)), Q15.2
unnamed: LED4.4 (BLUE), R11.2
unnamed: R12.1, U$1.22 (LED15)
unnamed: R13.1, U$1.21 (LED14)
unnamed: R11.1, U$1.20 (LED13)
unnamed: R10.1, U$1.19 (LED12)
unnamed: R16.1, U$1.9 (LED3)
unnamed: R8.1, U$1.18 (LED11)
unnamed: R16.2, SV1.3
unnamed: R7.1, U$1.16 (LED9)
unnamed: R17.1, U$1.10 (LED4)
unnamed: R2.1, U$1.8 (LED2)
unnamed: R3.1, U$1.7 (LED1)
unnamed: R4.1, U$1.6 (LED0)
unnamed: R18.1, U$1.11 (LED5)
unnamed: R19.1, U$1.12 (LED6)
unnamed: R9.1, U$1.17 (LED10)
unnamed: R5.1, U$1.13 (LED7)
unnamed: R17.2, SV1.5
unnamed: R18.2, SV1.7
unnamed: R19.2, SV1.9
unnamed: R6.1, U$1.15 (LED8)
unnamed: C9.1, IC1.21 (AREF)
unnamed: IC1.17 (PB3(MOSI/OC2)), JP6.4, U$3.SDI
unnamed: L2.1, Q14.C, SV1.1
unnamed: Q14.B, R29.1
RST: C1.1, IC1.1 (PC6(/RESET)), JP6.5, R1.1, S1.1 (S), S1.2 (S1)
RXD: FTDI.4, IC1.2 (PD0(RXD))
SPEAKER: IC1.15 (PB1(OC1A)), R29.2
TXD: FTDI.5, IC1.3 (PD1(TXD))
VCC: C2.1, FTDI.3, IC2.2 (I), JP1.1, L2.2, LED1.2 (VCC), LED2.2 (VCC), LED3.2 (VCC), LED4.2 (VCC), SV1.2, SV1.4, SV1.6, SV1.8, SV1.10

Notes on the sheet:
address 0x40
PIEZO SPEAKER

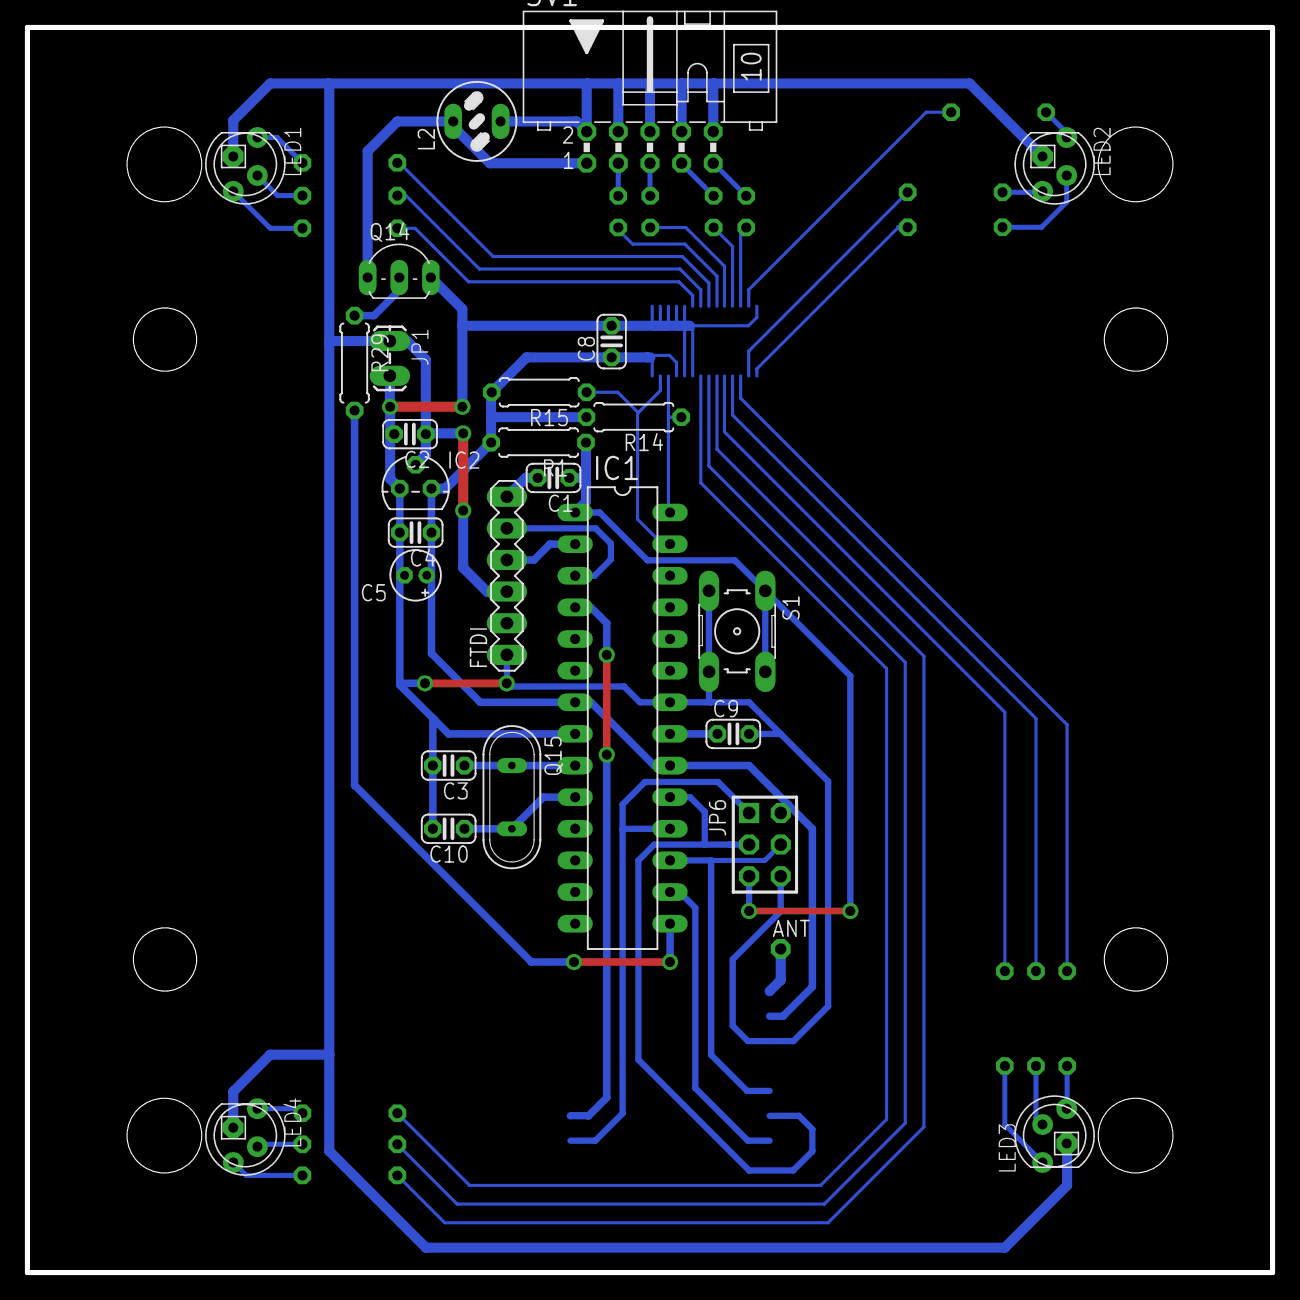
[picture p20: board ISA Ouderen - Lamp Ontvanger.brd from above]

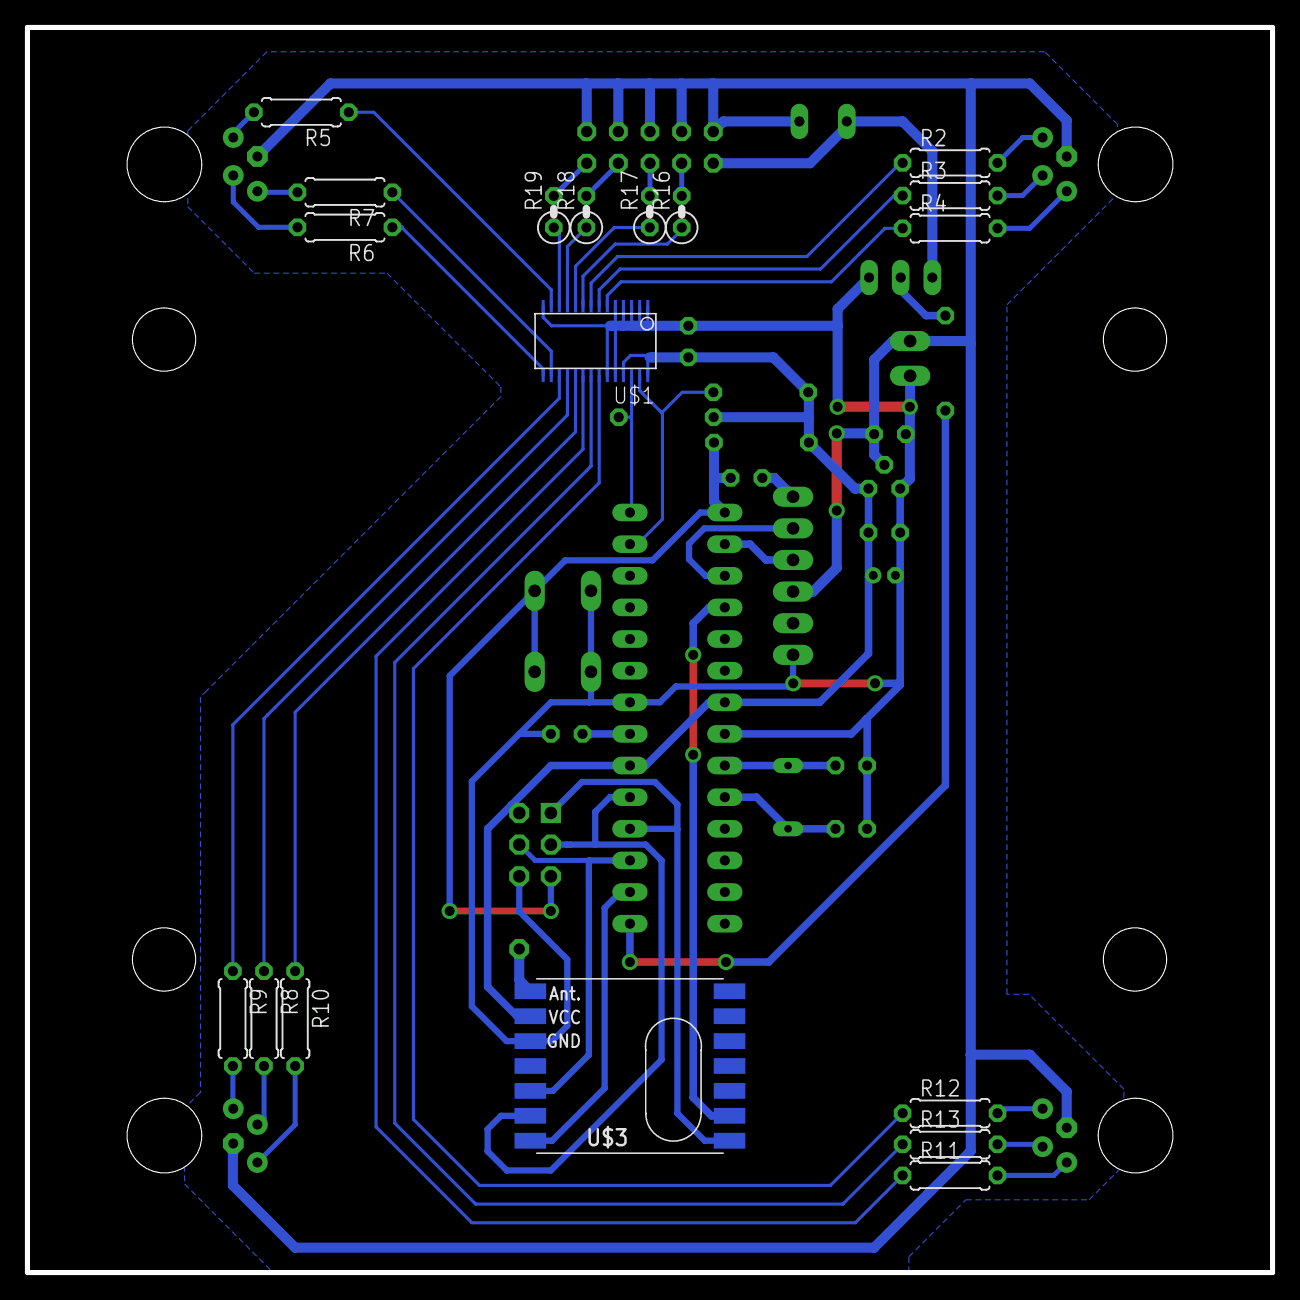
[picture p21: board ISA Ouderen - Lamp Ontvanger.brd from below]

Board: 2 copper layers, 100.0 x 100.0 mm, 45 parts (18 on the bottom side), 53 nets.
