arnemauer/IsaLib/ISA Gateway/Schematic - PCB/Central relay.brd

## EAGLE design ISA Gateway/Schematic - PCB/Central relay.brd (2013-10-27)

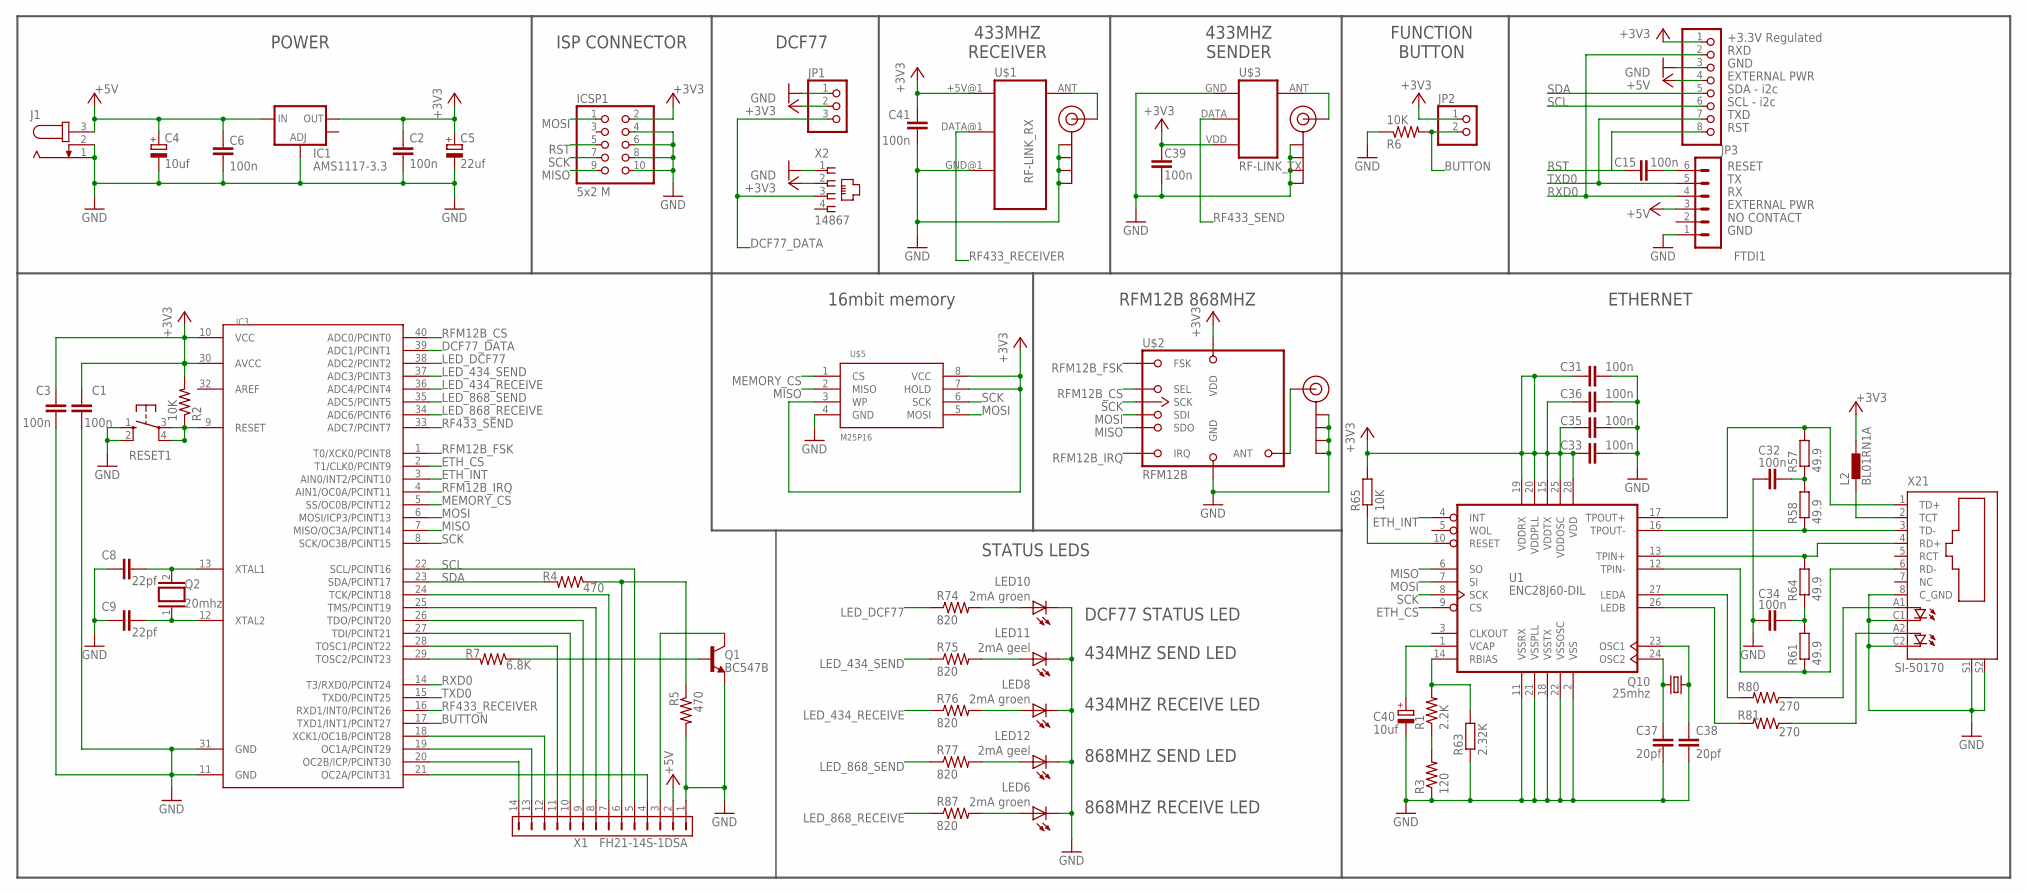
[picture p22: schematic Central relay.sch]

Parts:
C1, C2, C3, C6, C31, C32, C33, C34, C35, C36, C39, C41: 100n; 0805
C4, C40: 10uf; E2,5-6E
C5: 22uf; E2,5-6E
C8, C9: 22pf; 0805
C15: 100n; C025-025X050
C37, C38: 20pf; 0805
FTDI1: FTDI; MA06-1
IC1: AMS1117-3.3; SOT223
IC3: MEGA1284P; DIL40
ICSP1: 5x2 M; 2X05
J1: JACK-PLUG0; SPC4077
J$1, J$2, J$3: SMA_EDGE; SMA-EDGE
JP1: PINHD-1X3; 1X03
JP2: PINHD-1X2; 1X02
JP3: PINHD-1X8; 1X08
L2: BL01RN1A
LED6, LED8, LED10: 2mA groen; LED5MM
LED11, LED12: 2mA geel; LED5MM
Q1: BC547B; TO92
Q2: 20mhz; QS
Q10: 25mhz; HC49/S
R1: 2.2K; 0805
R2, R6: 10K; 0805
R3: 120; 0805
R4, R5: 470; 0805
R7: 6.8K; 0805
R57, R58, R61, R64: 49.9; 0207/7
R63: 2.32K; 0207/7
R65: 10K; 0207/7
R74, R75, R76, R77, R87: 820; 0805
R80, R81: 270; 0805
RESET1: 10-XX; B3F-10XX
U1: ENC28J60-DIL; DIL28-3
U$1: RF-LINK_RX
U$2: RFM12B; RFM12B-BREAKOUT-BASE
U$3: RF-LINK_TX
U$5: M25P16; SO08
X1: FH21-14S-1DSA
X2: 14867
X21: SI-50170

Connections:
+3V3: C1.2, C2.2, C3.2, C5.+, C31.1, C33.1, C35.2, C36.2, C39.2, C41.1, IC1.2 (OUT), IC3.10 (VCC), IC3.30 (AVCC), ICSP1.2, JP1.2, JP2.1, JP3.1, L2.2, R2.2, R65.2, U1.15 (VDDTX), U1.19 (VDDRX), U1.20 (VDDPLL), U1.25 (VDDOSC), U1.28 (VDD), U$1.+5V@1 (+5V), U$2.9 (VDD), U$3.VDD (GND), U$5.3 (WP), U$5.7 (HOLD), U$5.8 (VCC), X2.2
+5V: C4.+, C6.2, FTDI1.3, IC1.3 (IN), J1.3, JP3.4, X1.2
BUTTON: IC3.17 (TXD1/INT1/PCINT27), JP2.2, R6.2
DCF77_DATA: IC3.39 (ADC1/PCINT1), JP1.3, X2.3
ETH_CS: IC3.2 (T1/CLK0/PCINT9), U1.9 (CS)
ETH_INT: IC3.3 (AIN0/INT2/PCINT10), U1.4 (INT)
GND: C1.1, C2.1, C3.1, C4.-, C5.-, C6.1, C8.2, C9.2, C31.2, C32.1, C33.2, C34.1, C35.1, C36.1, C37.1, C38.1, C39.1, C40.-, C41.2, FTDI1.1, IC1.1 (ADJ), IC3.11 (GND), IC3.31 (GND), ICSP1.4, ICSP1.6, ICSP1.8, ICSP1.10, J1.1, J1.2, J$1.GND@0 (GND), J$1.GND@1 (GND), J$1.GND@2 (GND), J$1.GND@3 (GND), J$2.GND@0 (GND), J$2.GND@1 (GND), J$2.GND@2 (GND), J$2.GND@3 (GND), J$3.GND@0 (GND), J$3.GND@1 (GND), J$3.GND@2 (GND), J$3.GND@3 (GND), JP1.1, JP3.3, LED6.K (C), LED8.K (C), LED10.K (C), LED11.K (C), LED12.K (C), Q1.1 (E), R3.1, R5.2, R6.1, R63.1, RESET1.1 (S), RESET1.2 (S1), U1.2 (VSS), U1.11 (VSSRX), U1.18 (VSSTX), U1.21 (VSSPLL), U1.22 (VSSOSC), U$1.GND@1 (GND), U$2.10 (GND), U$3.GND (+5V), U$5.4 (GND), X1.1, X2.1, X21.8 (C_GND), X21.C1 (C), X21.C2 (C1), X21.S1, X21.S2
LED_434_RECEIVE: IC3.36 (ADC4/PCINT4), R76.1
LED_434_SEND: IC3.37 (ADC3/PCINT3), R75.1
LED_868_RECEIVE: IC3.34 (ADC6/PCINT6), R87.1
LED_868_SEND: IC3.35 (ADC5/PCINT5), R77.1
LED_DCF77: IC3.38 (ADC2/PCINT2), R74.1
MEMORY_CS: IC3.5 (SS/OC0B/PCINT12), U$5.1 (CS)
MISO: IC3.7 (MISO/OC3A/PCINT14), ICSP1.9, U1.6 (SO), U$2.1 (SDO), U$5.2 (MISO)
MOSI: IC3.6 (MOSI/ICP3/PCINT13), ICSP1.1, U1.7 (SI), U$2.12 (SDI), U$5.5 (MOSI)
unnamed: J$2.SIG (SIGNAL), U$1.ANT
unnamed: R80.1, X21.A1 (A)
unnamed: J$3.SIG (SIGNAL), U$3.ANT
unnamed: R1.1, R3.2
unnamed: R1.2, R63.2, U1.14 (RBIAS)
unnamed: R81.1, X21.A2 (A1)
unnamed: LED8.A, R76.2
unnamed: IC3.21 (OC2A/PCINT31), X1.4
unnamed: Q1.3 (C), X1.3
unnamed: Q1.2 (B), R7.1
unnamed: R4.1, R5.1, X1.6
unnamed: IC3.29 (TOSC2/PCINT23), R7.2
unnamed: LED11.A, R75.2
unnamed: IC3.24 (TCK/PCINT18), X1.7
unnamed: IC3.25 (TMS/PCINT19), X1.8
unnamed: IC3.26 (TDO/PCINT20), X1.9
unnamed: LED10.A, R74.2
unnamed: IC3.27 (TDI/PCINT21), X1.10
unnamed: IC3.28 (TOSC1/PCINT22), X1.11
unnamed: LED6.A, R87.2
unnamed: LED12.A, R77.2
unnamed: C8.1, IC3.13 (XTAL1), Q2.2
unnamed: L2.1, X21.2 (TCT)
unnamed: C34.2, R61.2, R64.1
unnamed: R57.2, U1.17 (TPOUT+), X21.1 (TD+)
unnamed: R58.1, U1.16 (TPOUT-), X21.3 (TD-)
unnamed: IC3.20 (OC2B/ICP/PCINT30), X1.14
unnamed: IC3.19 (OC1A/PCINT29), X1.13
unnamed: IC3.18 (XCK1/OC1B/PCINT28), X1.12
unnamed: C9.1, IC3.12 (XTAL2), Q2.1
unnamed: C15.2, FTDI1.6
unnamed: R64.2, U1.13 (TPIN+), X21.4 (RD+)
unnamed: R61.1, U1.12 (TPIN-), X21.6 (RD-)
unnamed: C37.2, Q10.1, U1.24 (OSC2)
unnamed: C38.2, Q10.2, U1.23 (OSC1)
unnamed: C40.+, U1.1 (VCAP)
unnamed: R65.1, U1.10 (RESET)
unnamed: C32.2, R57.1, R58.2
unnamed: R80.2, U1.27 (LEDA)
unnamed: R81.2, U1.26 (LEDB)
unnamed: J$1.SIG (SIGNAL), U$2.8 (ANT)
RF433_RECEIVER: IC3.16 (RXD1/INT0/PCINT26), U$1.DATA@1 (DATA)
RF433_SEND: IC3.33 (ADC7/PCINT7), U$3.DATA
RFM12B_CS: IC3.40 (ADC0/PCINT0), U$2.14 (SEL)
RFM12B_FSK: IC3.1 (T0/XCK0/PCINT8), U$2.3 (FSK)
RFM12B_IRQ: IC3.4 (AIN1/OC0A/PCINT11), U$2.2 (IRQ)
RST: C15.1, IC3.9 (RESET), ICSP1.5, JP3.8, R2.1, RESET1.3, RESET1.4 (P1)
RXD0: FTDI1.4, IC3.14 (T3/RXD0/PCINT24), JP3.2
SCK: IC3.8 (SCK/OC3B/PCINT15), ICSP1.7, U1.8 (SCK), U$2.13 (SCK), U$5.6 (SCK)
SCL: IC3.22 (SCL/PCINT16), JP3.6, X1.5
SDA: IC3.23 (SDA/PCINT17), JP3.5, R4.2
TXD0: FTDI1.5, IC3.15 (TXD0/PCINT25), JP3.7

Notes on the sheet:
GND
EXTERNAL PWR
NO CONTACT
RESET
SCL - i2c
SDA - i2c
433MHZ SENDER
433MHZ RECEIVER
ISP CONNECTOR
ETHERNET
RFM12B 868MHZ
STATUS LEDS
868MHZ RECEIVE LED
868MHZ SEND LED
434MHZ SEND LED
434MHZ RECEIVE LED
16mbit memory
DCF77
DCF77 STATUS LED
POWER
+3.3V Regulated
RXD
TXD
RST
FUNCTION BUTTON

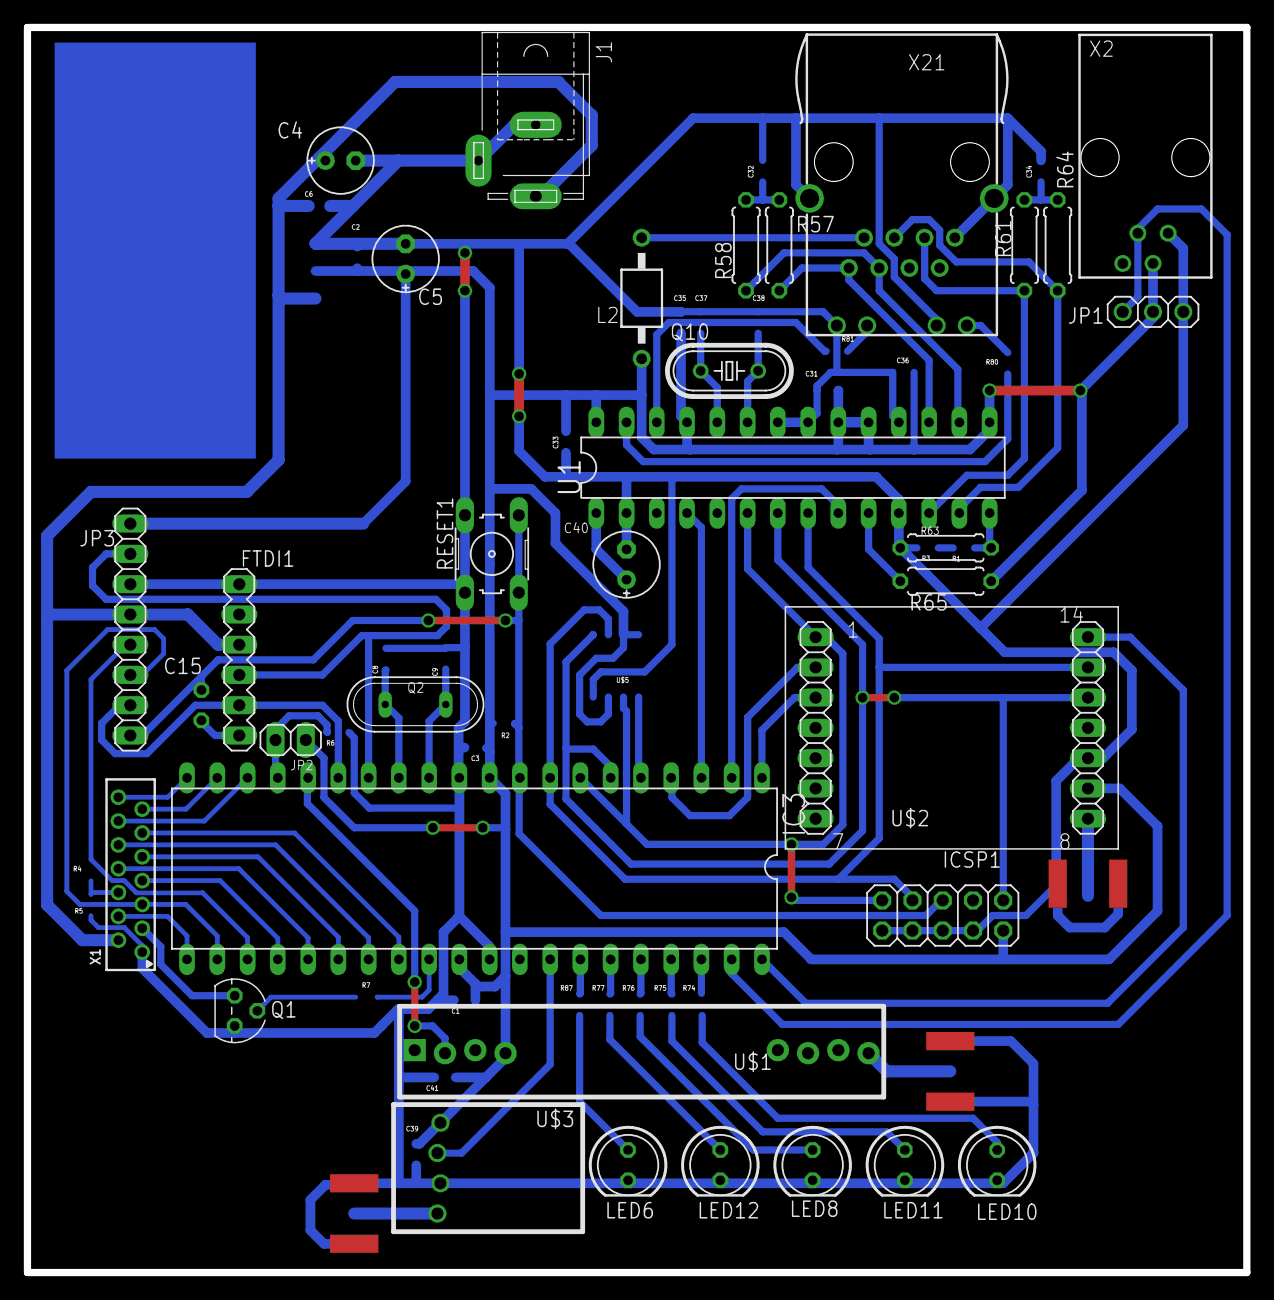
[picture p23: board Central relay.brd from above]

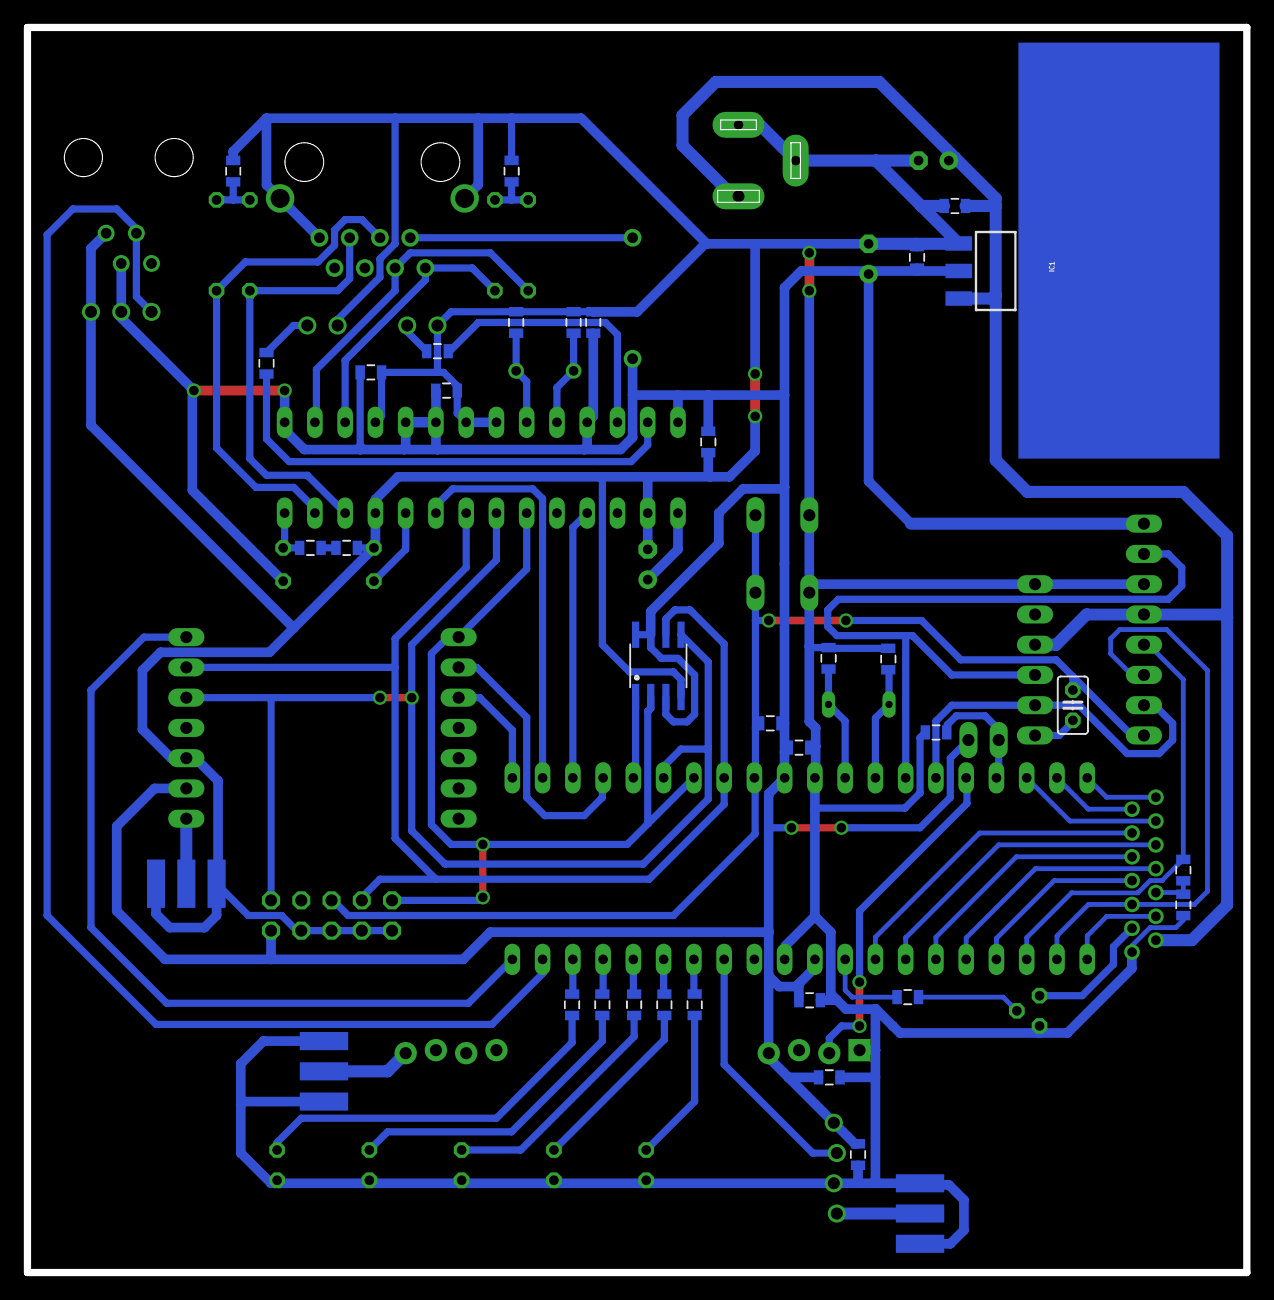
[picture p24: board Central relay.brd from below]

Board: 2 copper layers, 102.4 x 104.5 mm, 69 parts (36 on the bottom side), 67 nets.
