arnemauer/IsaLib/(commit log)

2013-10-27 RFM12B library + 2 projects (isa gateway + ISA doorbell)
    [Central relay.brd, Central relay.sch]
2013-10-28 Pictogrammen voor in de lamp toegevoegd
2013-10-29 Schema ISA ouderen lamp toegevoegd
    [BOM lijst.xlsx, ISA Ouderen - Lamp Ontvanger.sch, jlpcb-128.brd]
2013-10-29 Eerste schema met led printplaten
    [ISA Ouderen - Lamp Ontvanger.sch]
2013-10-30 Weerstanden toegevoegd aan led printplaten, connecties led prints gemaakt
2013-10-31 Led pcb gemaakt
    [ISA Ouderen - Lamp Ontvanger.brd, ISA Ouderen - Lamp Ontvanger.sch]
2013-11-01 Board + schema
    http://dickbest.nl/index.php?_a=viewProd&productId=11468
    [ISA Ouderen - Lamp Ontvanger.brd]
2013-11-03 Aanpassing pcb en schema
    [ISA Ouderen - Lamp Ontvanger.brd, ISA Ouderen - Lamp Ontvanger.sch]
2013-11-04 Aanpassing PCB
    [ISA Ouderen - Lamp Ontvanger.brd, ISA Ouderen - Lamp Ontvanger.sch]
2013-11-15 TLC5490 toegevoegd om pwm functies te behouden, timer 0 en 1 nodig voor geluid!, schema aangepast.
    [ISA Ouderen - Lamp Ontvanger.brd, ISA Ouderen - Lamp Ontvanger.sch]
2013-11-16 TLC5490 vervangen door PCA9635 ivm standby stroomverbruik en componenten
    [ISA Ouderen - Lamp Ontvanger.brd, ISA Ouderen - Lamp Ontvanger.sch]
2013-11-16 PCA9635 toegevoegd, atmega omgezet naar SMD. Schema klaar. nu board nog.
    [ISA Ouderen - Lamp Ontvanger.brd, ISA Ouderen - Lamp Ontvanger.sch]
2013-11-17 PCB aangepast
    [ISA Ouderen - Lamp Ontvanger.brd, ISA Ouderen - Lamp Ontvanger.sch]
2013-11-18 PCB afgemaakt
    [ISA Ouderen - Lamp Ontvanger.brd, ISA Ouderen - Lamp Ontvanger.sch]
2013-11-20 BOM toegevoegd
    [BOM.xlsx]
2013-11-20 weerstanden voor de rgb leds toegevoegd
    [BOM.xlsx, ISA Ouderen - Lamp Ontvanger.brd, ISA Ouderen - Lamp Ontvanger.csv, ISA Ouderen - Lamp Ontvanger.sch]
2013-11-23 Arduino TONE AC toegevoegd, volgende keer -> omzetten naar C + toevoegen verschillende geluiden!!
2013-11-27 Spoel toegevoegd voor opzwepen piezo
    [ISA Ouderen - Lamp Ontvanger.brd, ISA Ouderen - Lamp Ontvanger.sch]
2013-11-29 pull-up weerstanden op sda / dcl lijn toegevoegd
    [ISA Ouderen - Lamp Ontvanger.brd, ISA Ouderen - Lamp Ontvanger.sch]
2013-11-29 PCB afgemaakt, BOM lijst aangevuld.
    [BOM lijst.xlsx, BOM.xlsx, ISA Ouderen - Lamp Ontvanger.brd, ISA Ouderen - Lamp Ontvanger.sch]
2013-11-30 BOM uitgebreid met prijzen
    [BOM.xlsx, ISA Ouderen - Lamp Ontvanger.csv]
2013-12-01 Bestanden met metingen deurbel toegevoegd
    [meting 1 benedenbel.XLS]
2013-12-01 BOM lijst aangepast, waarde van weerstanden RGB LEDS berekent, juiste transistor voor piezo element.
    [BOM.xlsx, ISA Ouderen - Lamp Ontvanger.brd, ISA Ouderen - Lamp Ontvanger.sch]
2013-12-07 Een print met daarop 5mm rgb leds ipv 4 losse printjes met smd leds. Dit ivm de ruimte in de lamp voor de batterijen. Kostprijs is ook lager :P
    [BOM.xlsx, ISA Ouderen - Lamp Ontvanger.brd, ISA Ouderen - Lamp Ontvanger.sch]
2013-12-09 Reset push button toegevoegd + voor een deel PCB aangepast aan nieuwe RGB 5mm leds.
    [ISA Ouderen - Lamp Ontvanger.brd, ISA Ouderen - Lamp Ontvanger.sch]
2013-12-10 TODO: weerstanden bij leds vervangen zodat voeding eronder kan lopen. Weerstanden bij reset en SDA SCL vervangen door normale
    [ISA Ouderen - Lamp Ontvanger.brd]
2013-12-11 PCB aanpassingen
    [ISA Ouderen - Lamp Ontvanger.brd, ISA Ouderen - Lamp Ontvanger.sch]
2013-12-11 Spoorbreedtes aangepast voor de PCA9635. Weerstanden voor witte leds toegevoegd. PCB afgemaakt.
    [ISA Ouderen - Lamp Ontvanger.brd, ISA Ouderen - Lamp Ontvanger.sch]
2013-12-11 Kleine aanpassingen aan PCB
    [ISA Ouderen - Lamp Ontvanger.brd]
2013-12-13 groundplane toegevoegd
    [ISA Ouderen - Lamp Ontvanger.brd]
2013-12-19 PIEZO speaker op poort timer 1 gezet ivm kleinere code, beter geluid, minder clock cycles.
    [ISA Ouderen - Lamp Ontvanger.brd, ISA Ouderen - Lamp Ontvanger.sch]
2013-12-22 PIEZO op verkeerde pin gezet, pin veranderd en pcb aangepast.
    [ISA Ouderen - Lamp Ontvanger.brd, ISA Ouderen - Lamp Ontvanger.sch]
2013-12-22 Code aangepast -> kleine functie opbouw gemaak; c code voor aansturing pca9635 gevonden;
    uitzoeken: manier van aansturen leds dmv patterns. bijv. in arrays? of...
2013-12-23 Begin Flowchart voor programma gemaakt
2013-12-26 i2c master lib toegevoegd; begin pca9635 library gemaakt, werkt :)
2014-01-02 slaap nog niet werkend, interrupt zorgt er niet voor dat loop weer begin te lopen...
2014-01-03 Sleep ok door verwijderen van uart debug info.
2014-01-04 proberen om struct array in progmem te persen.
2014-01-07 struct in progmem retourneert verschillende waardes over uart0
2014-01-09 while loop klaar; TODO: ISR timer 2, led patronen, geluidspatronen
2014-01-09 Begin overname flowchart in C; aanpassingen in PCA9635; TODO: ISR timer 2
2014-01-12 geluidsduur in interrupt klopt niet, duur is te kort en lijkt niet uit array te komen.
2014-01-12 Geluid, flash, en icoon werkt. TODO: bug in geluid!
    [ONTVANGER.cpp, pca9635.c, pca9635.h]
2014-02-01 Aanpassing gemaakt om uc in diepe slaap te krijgen. TODO: low duty cycle instellen voor de RFM12B http://harizanov.com/2012/11/low-power-receiver-options/
2014-02-02 Kristal vervangen door keramisch type. Na versturen van pakket licht led 1 maal op, daarna geen andere interrupts. Uitzoeken ivm power dwn.
2014-02-03 Fuse veranderd naar 0x05 ivm error. 0x05 == 0xFD.
2014-04-09 Schema voor zender gemaakt. Telefoondeel toegevoegd. TODO: deurbel deel.
    [ISA Ouderen - Lamp Ontvanger.brd, ISA Ouderen - Lamp Ontvanger.csv, ISA Ouderen - Lamp Ontvanger.sch, ISA Ouderen - Lamp Zender.brd, ISA Ouderen - Lamp Zender.sch, jlpcb-128.brd, meting 1 benedenbel.XLS]
2014-04-10 weerstand berkeent voor 6n138
    [ISA Ouderen - Lamp Ontvanger.sch]
2014-04-11 Kleine verandering in schema zender
    [ISA Ouderen - Lamp Ontvanger.csv, ISA Ouderen - Lamp Zender.brd, ISA Ouderen - Lamp Zender.sch]
2014-04-18 6n138 toegevoegd voor telefoondetectie en deurbeldetectie + weerstand berekening.
    [ISA Ouderen - Lamp Zender.brd]
2014-04-20 board aanpassingne
    [ISA Ouderen - Lamp Zender.brd]
2014-05-01 Test waarom standby stand wel de data goed verwerkt en bij power-down niet. Bij standby is er weinig tijd tussen de interrupt van de rfm12b en het vervolgens uitlezen van de bytes uit de rfm12b. Bij 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
2014-05-06 Code klaar en werkend
    [USBasp.sch]
2014-05-14 Kleine aanpassingen
    [logic laatste pakket en daarna geen reactie meer.csv, logic pakket ontvangen en ok terugsturen.csv]
2014-05-14 Kleine wijzigingen en foutopsporing
    [logic laatste pakket en daarna geen reactie meer.csv, logic laatste pakket en daarna geen reactie meer.xlsx, logic pakket ontvangen en ok terugsturen.csv]
2014-05-16 Kleine wijzigingen om fouten op te sporen.
    [untitled.csv]
2014-05-16 Zuiniger gemaakt. Na ontvangst van aantal testbytes reageert de lamp niet meer. Schakelt opnieuw naar idle en daarna niets?!
2014-05-20 Compleet werkend!
    Kleine aanpassingen in de code:
    - CRC check NA rf12_recvdone(); bij een pakket met verkeerde CRC gaat de uc slapen en zal de rfm12b radio niet meer uit idle halen. De while loop moet dan nog een keer starten ipv direct slapen.
    - aanpassingen geluid van hulp
    - aanpassingen in icon licht; stap 11 (100% aan) korter gemaakt.
2014-05-21 Voorbereidingen getroffen voor Deurbelzender en een losse telefoonzender.
    [BOM.xlsx, ISA Ouderen - Lamp Ontvanger.brd, ISA Ouderen - Lamp Ontvanger.csv, ISA Ouderen - Lamp Ontvanger.sch, ISA Ouderen - Lamp Zender.brd, ISA Ouderen - Lamp Zender.sch, jlpcb-128.brd, logic laatste pakket en daarna geen reactie meer.csv]
2014-05-24 Zender deurbel schema en pcb aangepast
    [ISA Ouderen - Lamp Zender.brd, ISA Ouderen - Lamp Zender.sch]
2014-05-24 Kleine aanpasingen pcb zender
    [ISA Ouderen - Lamp Zender.brd, ISA Ouderen - Lamp Zender.sch]
2014-05-28 kleine pcb wijzigingen
    [ISA Ouderen - Lamp Zender.brd, ISA Ouderen - Lamp Zender.sch, jlpcb-124.brd, jlpcb-124.sch, jlpcb-128.brd]
2014-05-29 pcb bijna klaar
    [ISA Ouderen - Lamp Zender.brd, ISA Ouderen - Lamp Zender.sch, jlpcb-124.brd, jlpcb-124.sch, jlpcb-128.brd]
2014-05-31 kleine wijzigingen in pcb
    [ISA Ouderen - Lamp Zender.brd, ISA Ouderen - Lamp Zender.sch]
2014-05-31 Wijzingen in PCB, bijna klaar!
    [ISA Ouderen - Lamp Zender.brd, ISA Ouderen - Lamp Zender.sch]
2014-06-02 PCB ready!
    [ISA Ouderen - Lamp Zender.GBL, ISA Ouderen - Lamp Zender.GBO, ISA Ouderen - Lamp Zender.GBP, ISA Ouderen - Lamp Zender.GBS, ISA Ouderen - Lamp Zender.GKO, ISA Ouderen - Lamp Zender.GTL, ISA Ouderen - Lamp Zender.GTO, ISA Ouderen - Lamp Zender.GTP]
2014-06-02 Kleine fouten in pcb aangepast: - batterijhouder naar de achterkant - wirepad verder uit elkaar
    [ISA Ouderen - Lamp Zender.GBL, ISA Ouderen - Lamp Zender.GBO, ISA Ouderen - Lamp Zender.GBP, ISA Ouderen - Lamp Zender.GBS, ISA Ouderen - Lamp Zender.GKO, ISA Ouderen - Lamp Zender.GTL, ISA Ouderen - Lamp Zender.GTO, ISA Ouderen - Lamp Zender.GTP]
2014-06-08 Wijziging BOM en kleine wijziging onderdelen in schema.
    [ISA Ouderen - Lamp Zender (versie 1).xlsx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]
2014-07-06 Wijzigingen in zender firmware ivm rfm69w. Voorbereiding zender gemaakt. Libs oké. Todo: mainloop met int check en daarna sleep.
    [ISA Ouderen - Lamp Zender (versie 1).xlsx]
2014-07-26 Allerhande aanpassingen
    [ISA Ouderen - Lamp Zender (versie 1).xlsx, ISA Ouderen - Lamp Zender.brd, ISA Ouderen - Lamp Zender.sch]
2014-09-13 RFM12B vervangen door RFM69 + transistor toegevoegd voor interrupt
    [logic laatste pakket en daarna geen reactie meer.csv, logic pakket ontvangen en ok terugsturen.csv, logic van zondag voor vinden resetfout.csv, untitled.csv]
2014-09-16 lamp ontvanger interrupt tijdens zenden aangepast. Interrupt na verzending pakket blijft totdat de modes aangepast is. Omdat interrupt low bleef doorgaan kreeg cpu geen mogelijkheid om modes te veran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
